github188/bmeter/Docs/无标题.png

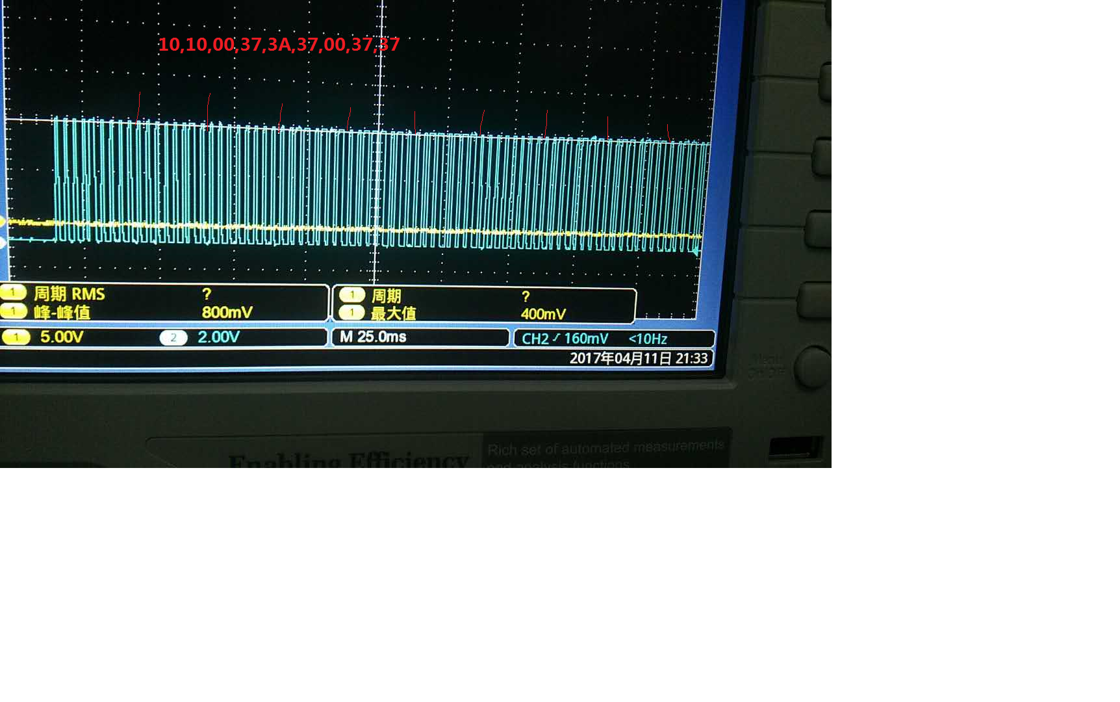
Docs/无标题.png
