github188/bmeter/Docs/JINPENG12080/微信图片_20171207090548.jpg

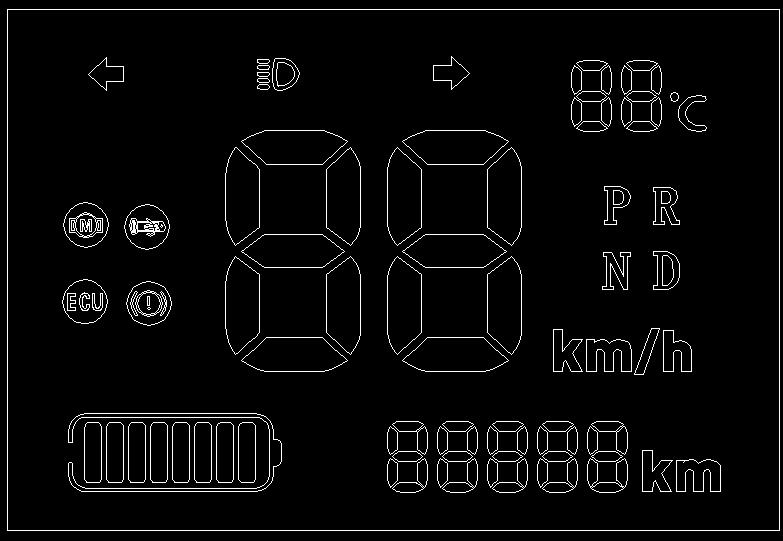
Docs/JINPENG12080/微信图片_20171207090548.jpg
