github188/bmeter/Docs/极客13050 仪表程序需求/Catch.jpg

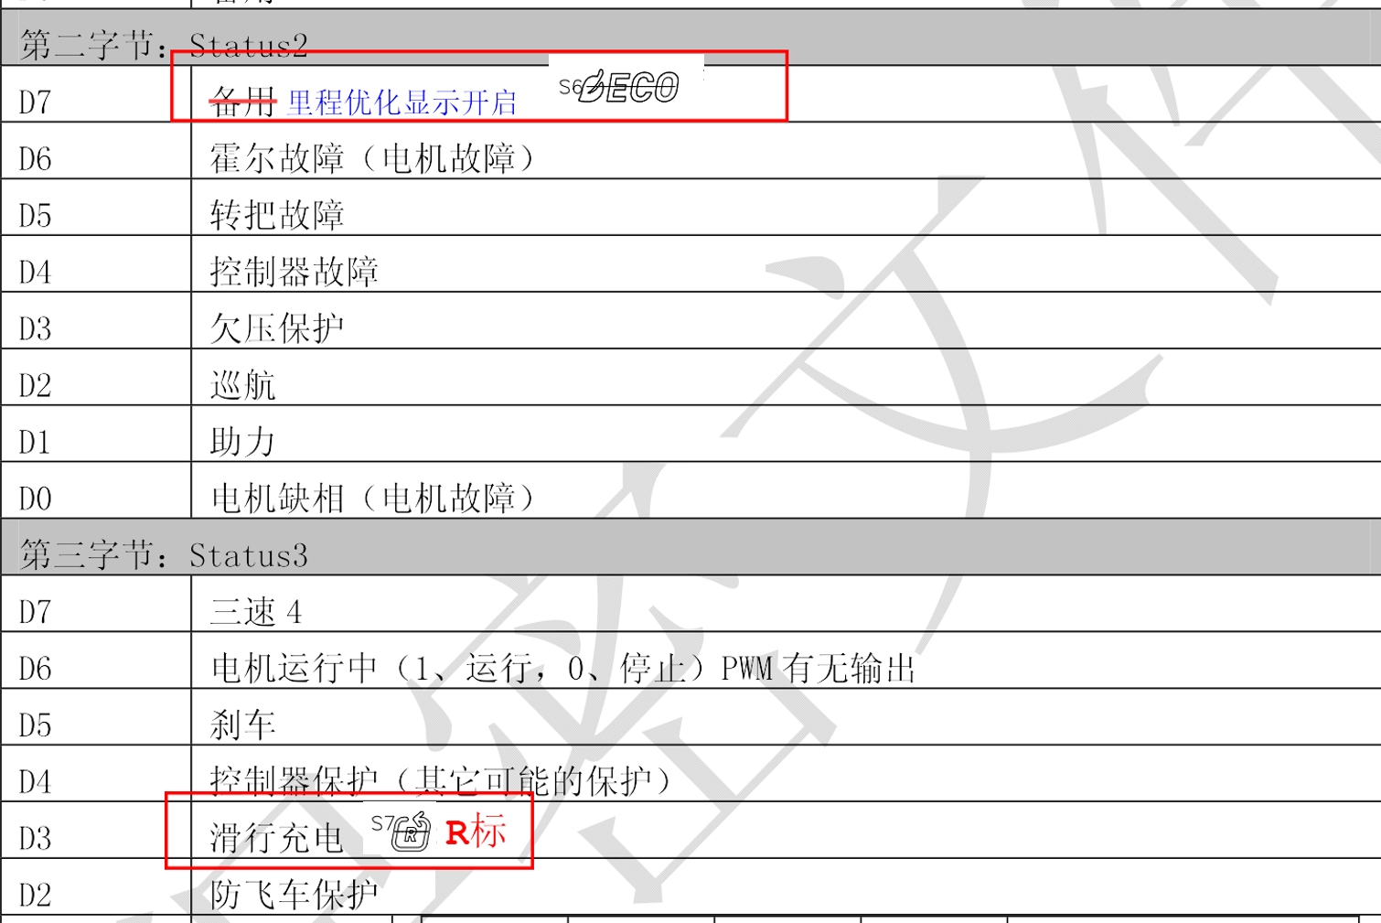
Docs/极客13050 仪表程序需求/Catch.jpg
