github188/bmeter/Docs/仪表软件设置要求/金彭4860 6072软件要求.pdf

48V系统 | 60V系统

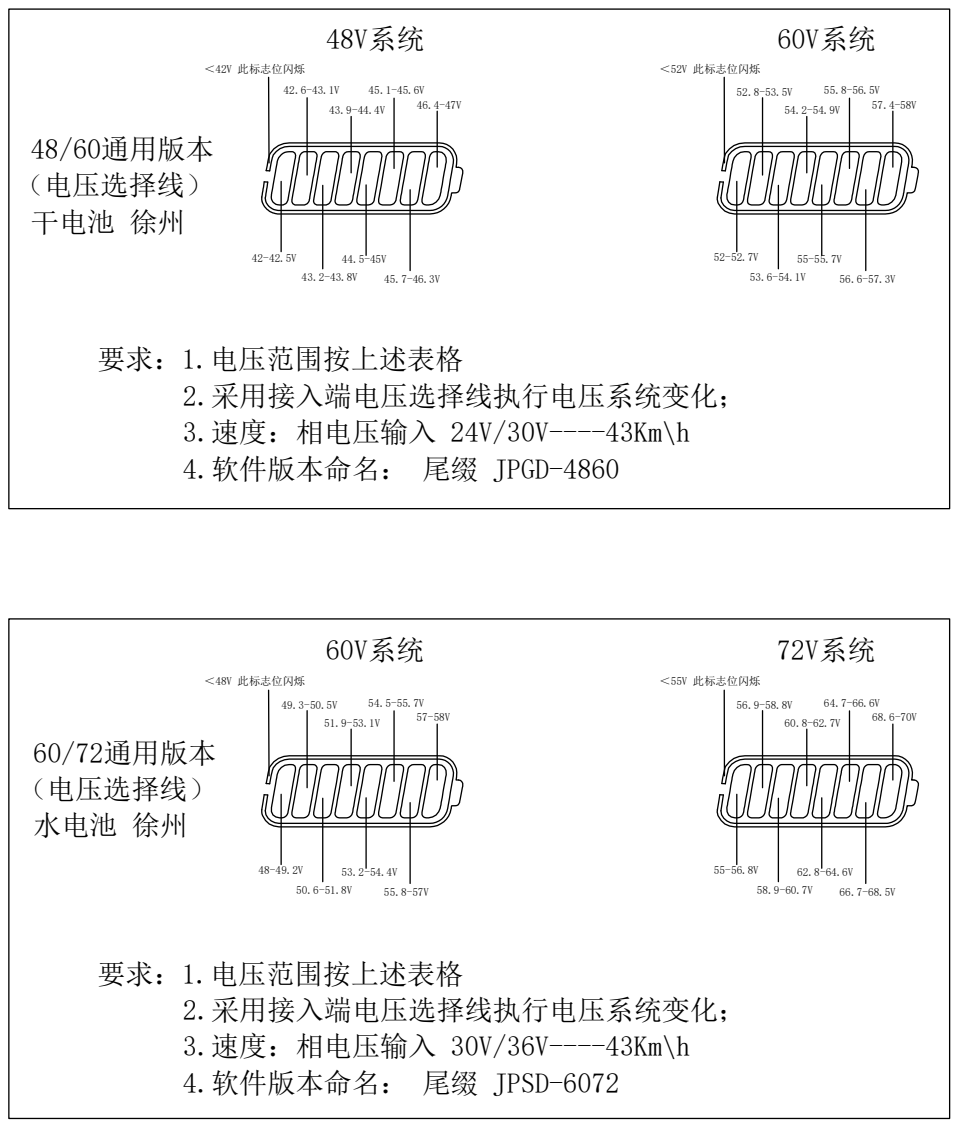
[picture p15: page 1]
42.6-43.1V ＜42V 此标志位闪烁; ＜52V 此标志位闪烁; ＜48V 此标志位闪烁; ＜55V 此标志位闪烁; 48/60通用版本 （电压选择线） 干电池 徐州; 60/72通用版本 （电压选择线） 水电池 徐州; 60V系统; 72V系统; 要求：1.电压范围按上述表格

2.采用接入端电压选择线执行电压系统变化；
3.速度：相电压输入 24V/30V----43Km\h
4.软件版本命名： 尾缀 JPGD-4860

3.速度：相电压输入 30V/36V----43Km\h
4.软件版本命名： 尾缀 JPSD-6072
