github188/bmeter/Docs/Meter011/9040.pdf

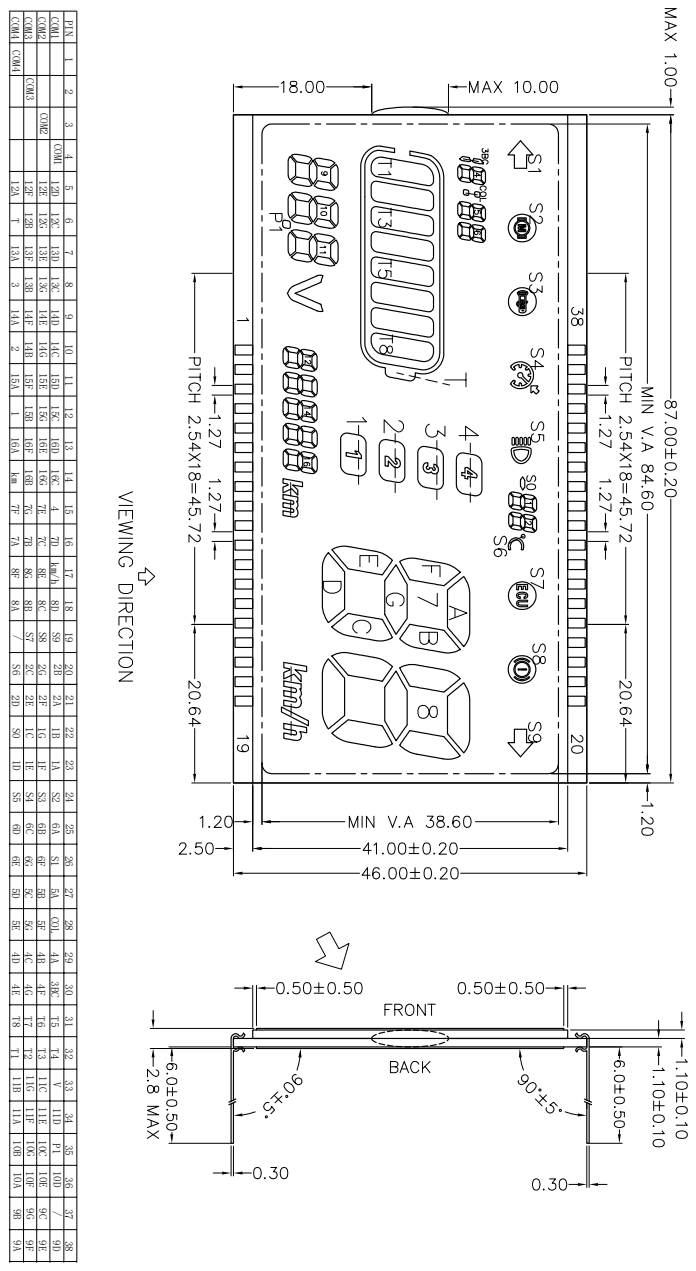
[picture p16: page 1]
PIN 1 2 3 4 5 6 7 8 9 10 11 12 13 14 15 16 17 18 19 20 21 22 23 24 25; COM1 COM1; COM2 COM2; 2E 1C 1E S4 6C COM3 COM3; COM4 COM4; S1 5A COL 4A 3BC
