github188/bmeter/Docs/Meter011/TimeMeter011.pdf

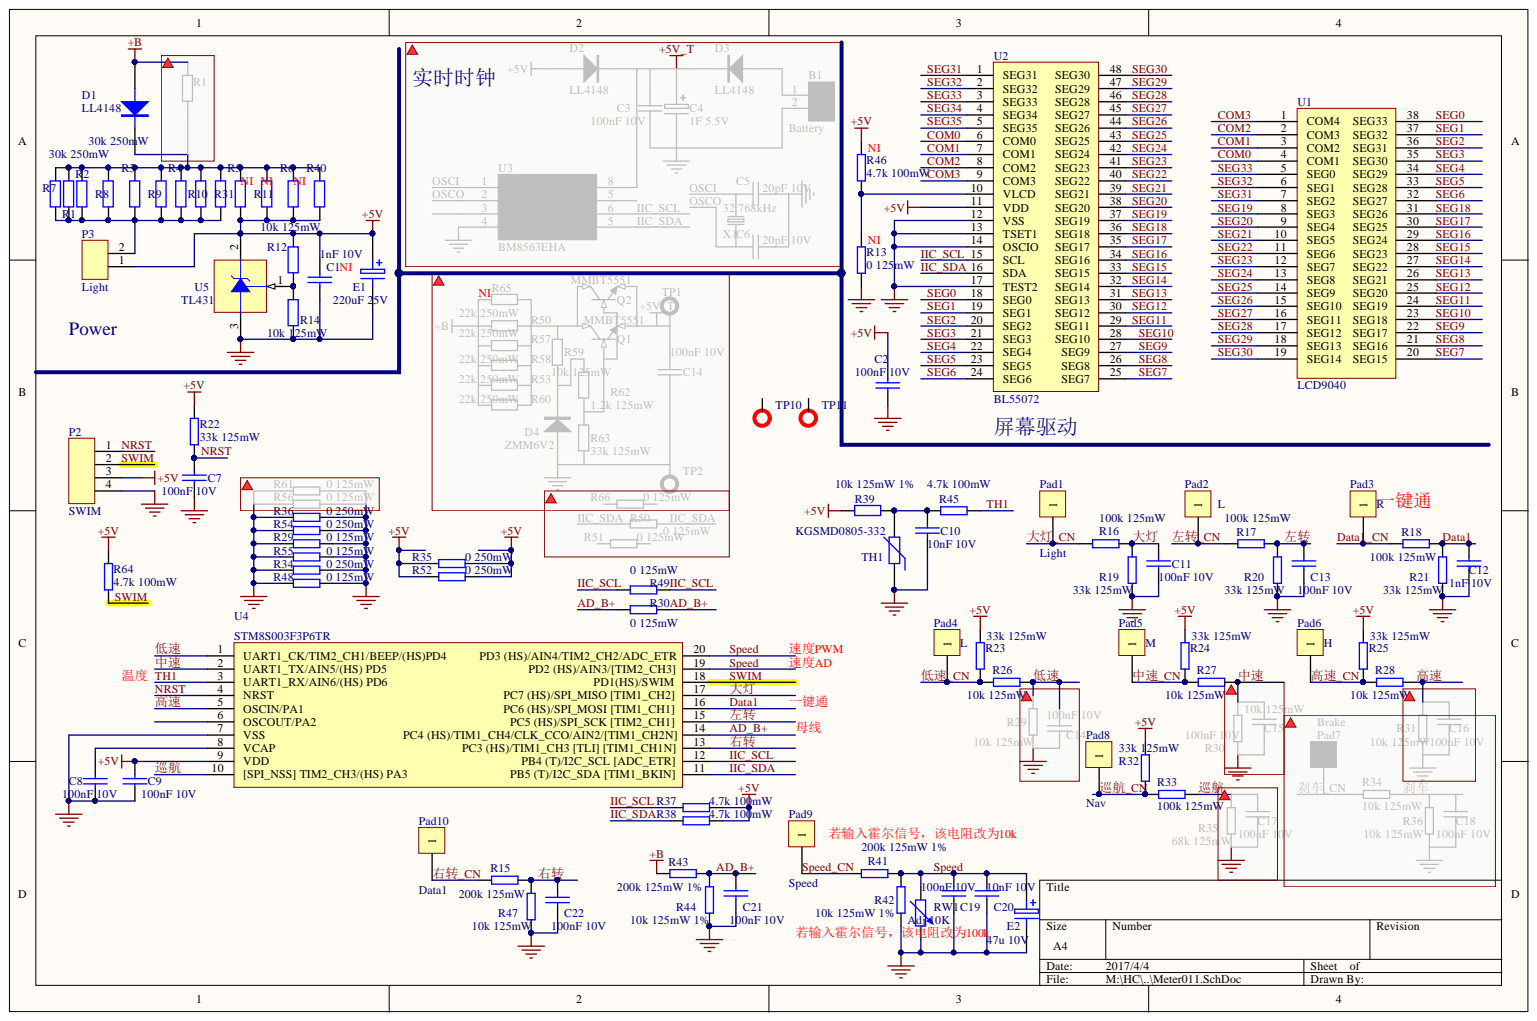
[picture p17: page 1]

SCL 15

1 U5 | MMBT5551 | TEST2 17 | SEG8 13

Brake

C8 | VCAP 8

VDD 9

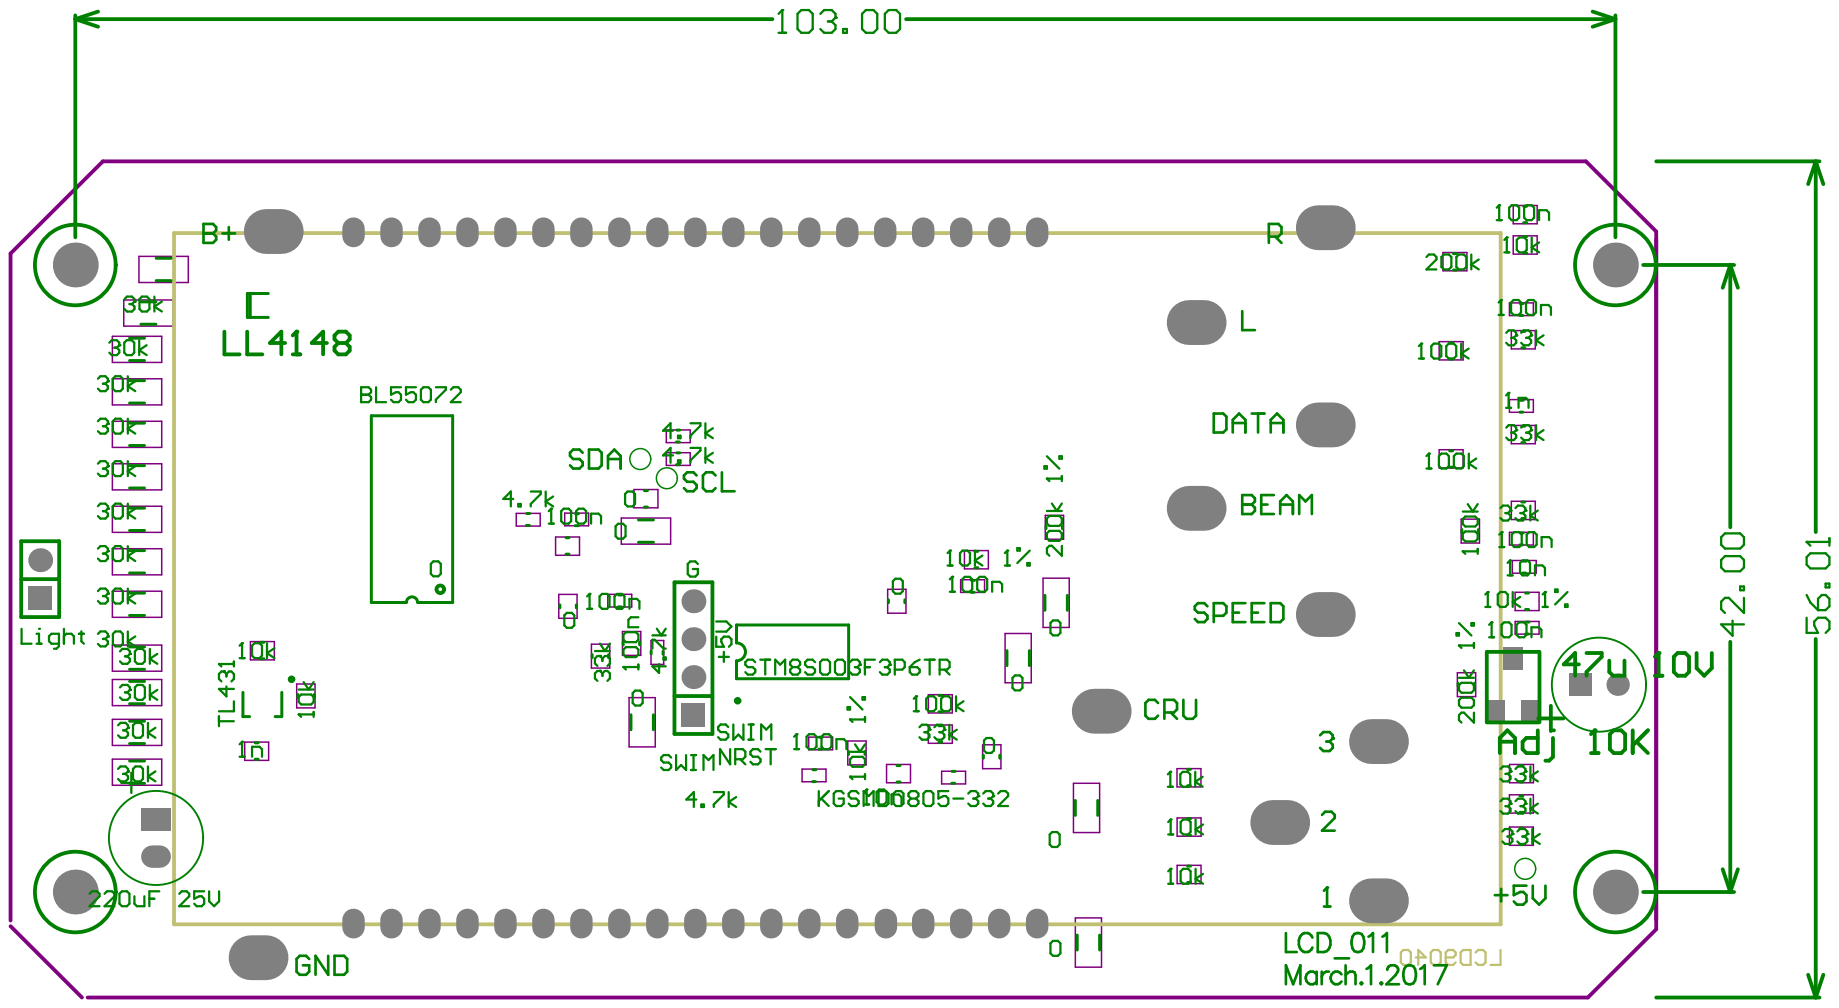
[picture p18: page 2]
