github188/bmeter/Docs/Meter013/Meter013.pdf

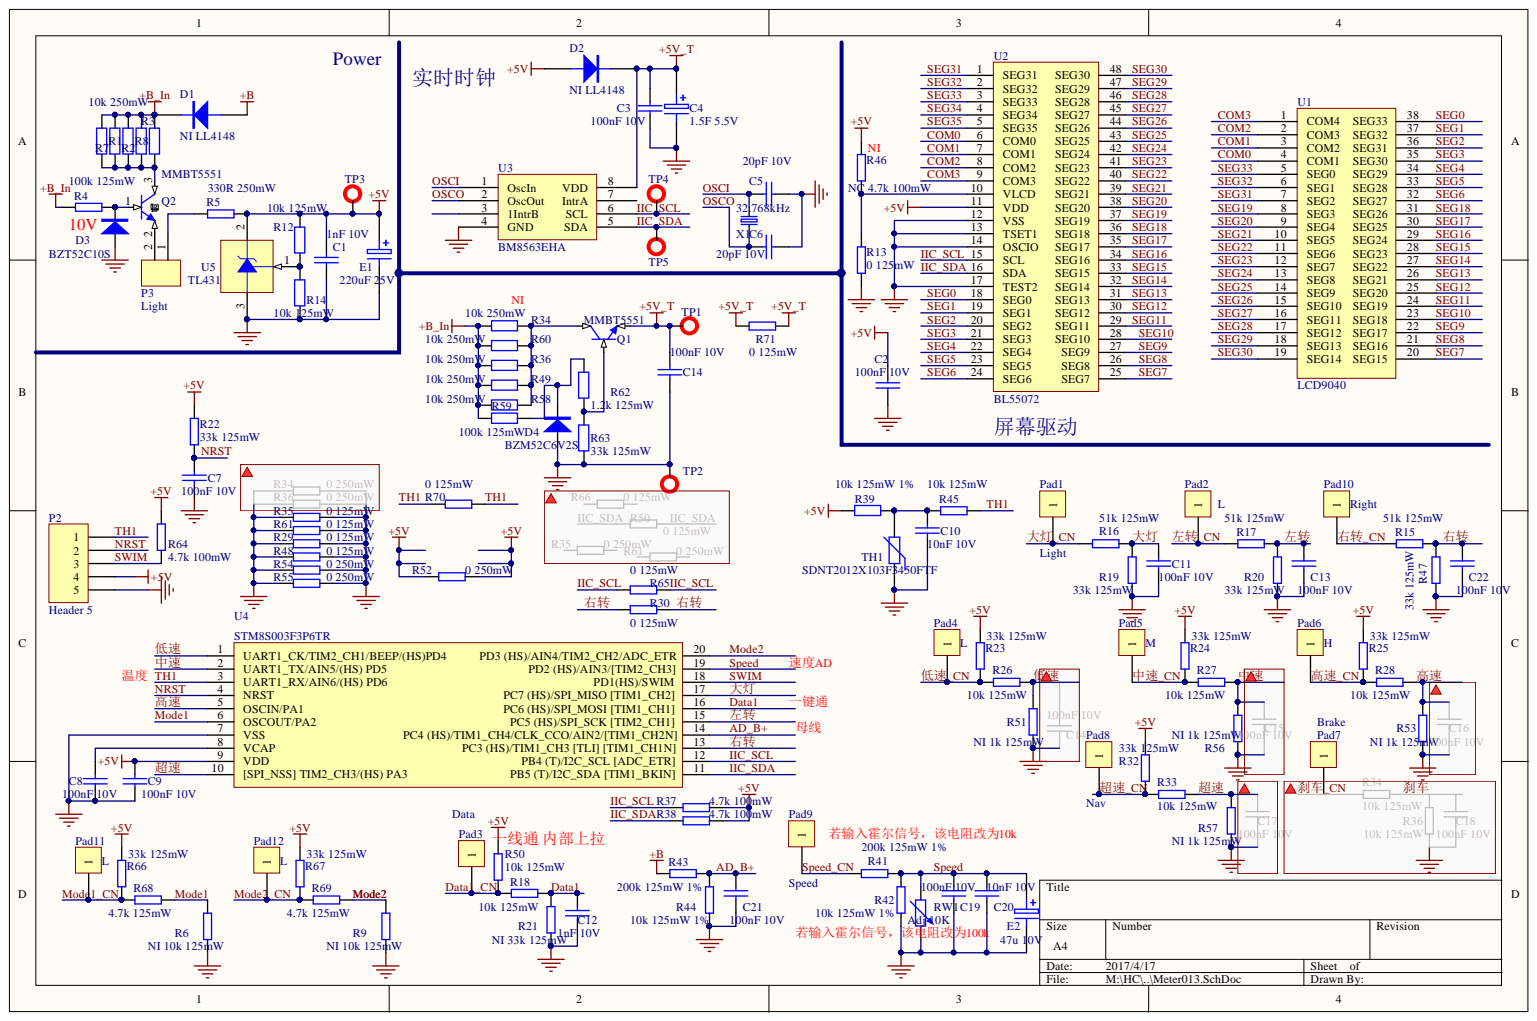
[picture p19: page 1]

TSET1 13

SCL 15

220uF 25V | NI +5V_T +5V_T +5V_T | TEST2 17 | SEG8 13

C8 | VCAP 8

VDD 9
