github188/bmeter/Docs/Meter022/5535.pdf

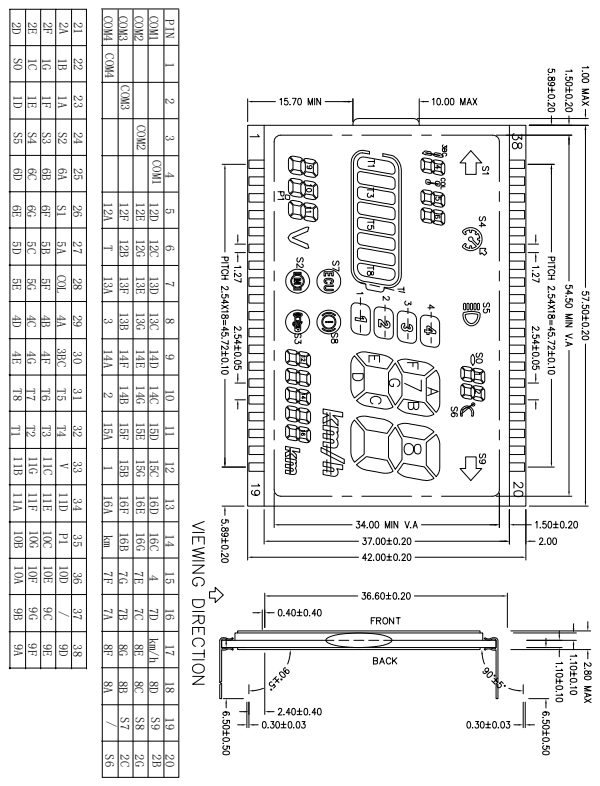
[picture p20: page 1]
PIN 1 2 3 4 5 6 7 8 9 10 11 12 13 14 15 16 17 18 19 20; COM1 COM1; COM2 COM2; COM3 COM3; COM4 COM4; S1 5A COL 4A 3BC
