github188/bmeter/Docs/Meter041/Meter041.pdf

SEG6 24 | SEG7 | 25 SEG8 | 26 SEG9 | 27 SEG10 | 28 SEG11 | 29 SEG12 | 30 SEG13 | 31 SEG14 | 32 SEG15 | 33 SEG16 | 34 SEG17 | 35 SEG18 | 36 SEG19 | 37 SEG20 | 38 SEG21 | 39 SEG22 | 40 SEG23 | 41 SEG24 | 42 SEG25 | 43 SEG26 | 44 SEG27 | 45 SEG28 | 46 SEG29 | 47 SEG30 | 48

## Power

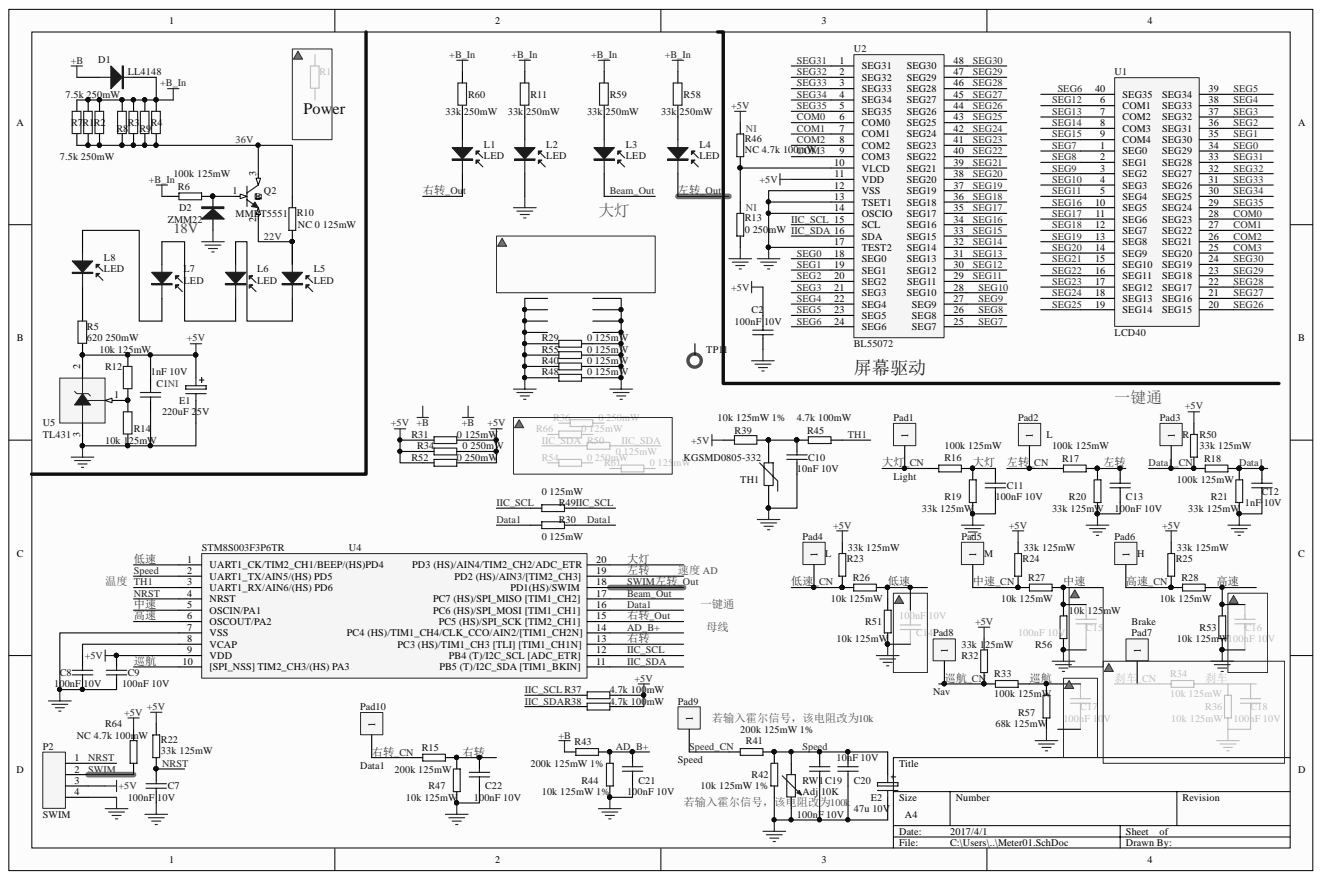
[picture p21: page 1]
