github188/bmeter/Docs/JINPENG12080/MR/MR9737V2.0.pdf

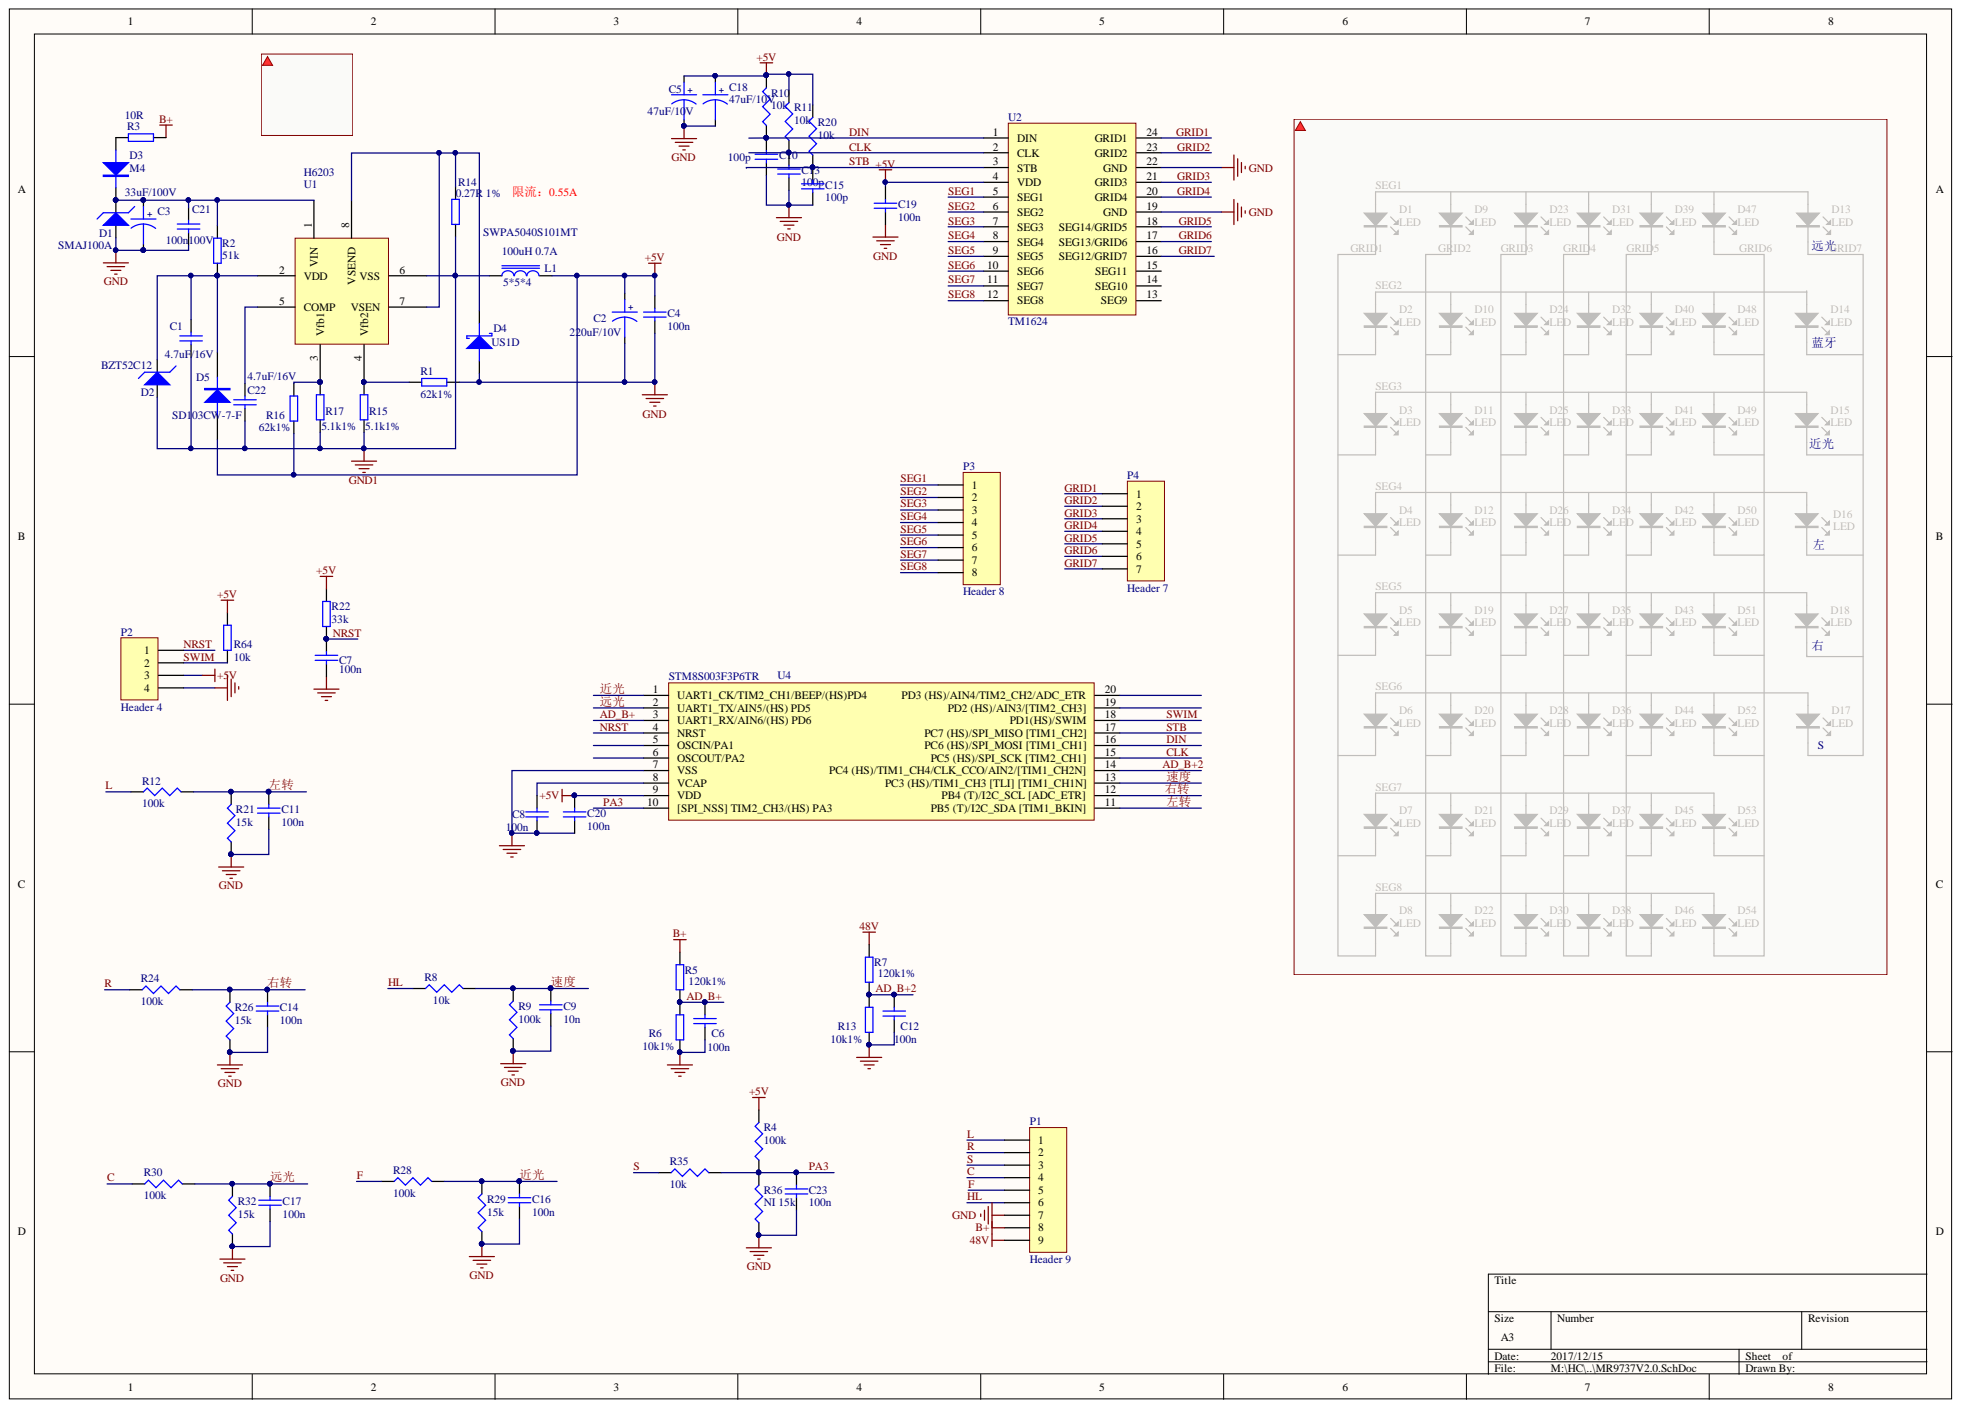
[picture p22: page 1]

4.7uF/16V | | COMP 5 | US1D

SEG3 | D48 LED

SEG4 | D49 LED

C8 | VCAP 8

VDD 9
