github188/bmeter/Docs/JINPENG12080/JP/驱动板/JP-QDB.pdf

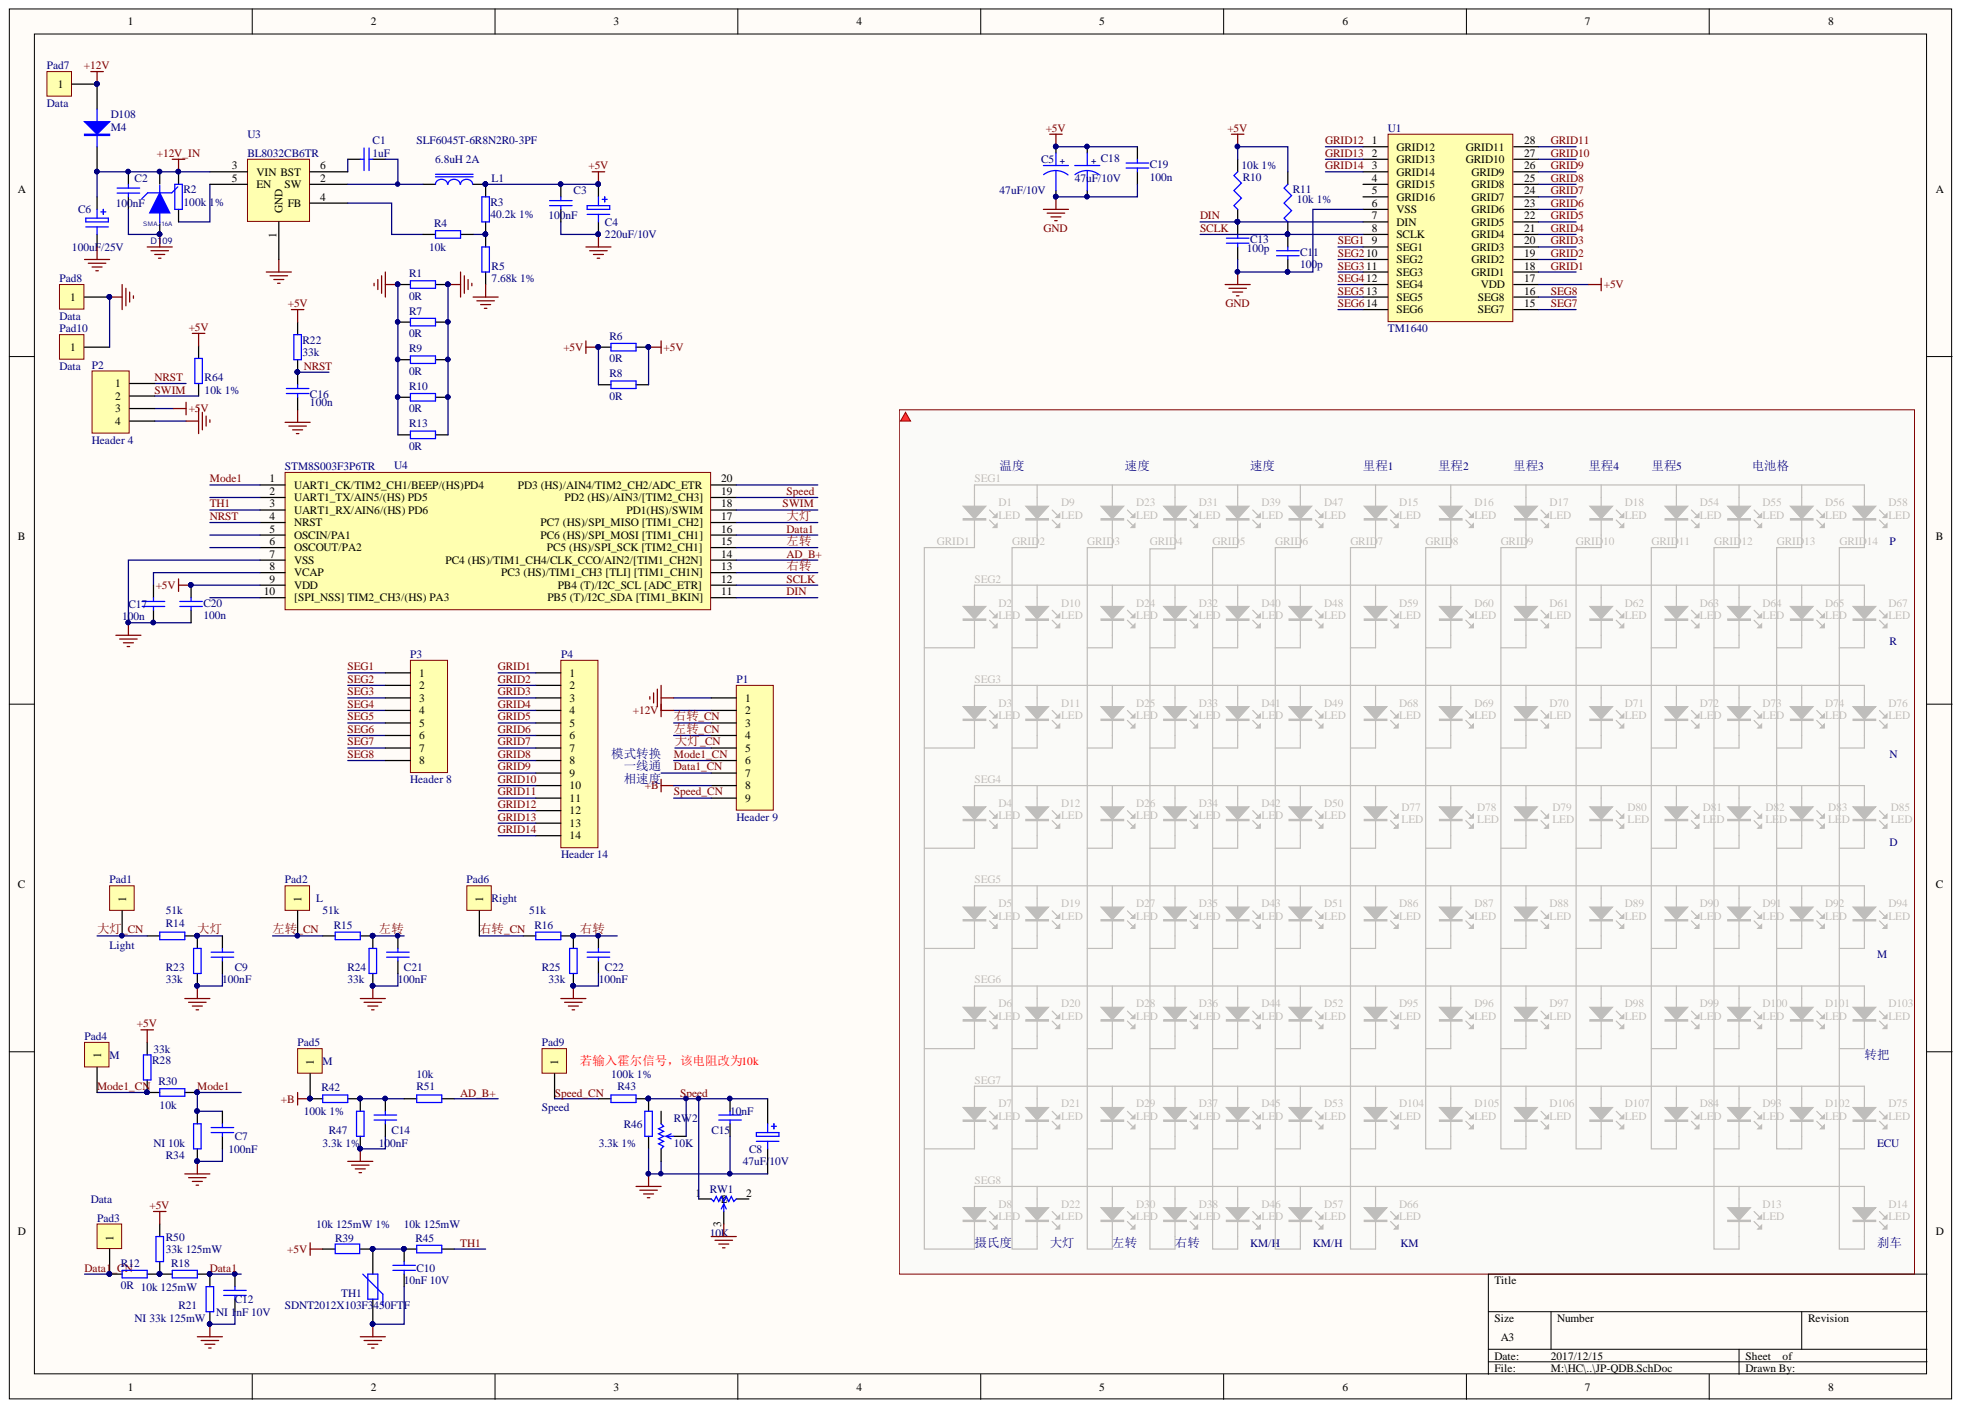
[picture p23: page 1]

C17 | VCAP 8

D2 LED SEG3 | D10 LED | D24 LED | D32 LED | D40 LED | D48 LED | D59 LED | D60 LED | D61 LED | D62 LED | D63 LED | D64

D5 LED SEG6 | D19 LED | D27 LED | D35 LED | D43 LED | D51 LED | D86 LED | D87 LED | D88 LED | D89 LED | D90 LED | D91 LED

D6 LED SEG7 | D20 LED | D28 LED | D36 LED | D44 LED | D52 LED | D95 LED | D96 LED | D97 LED | D98 LED | D99 LED | D100 LED | D101
