github188/bmeter/Docs/8807.pdf

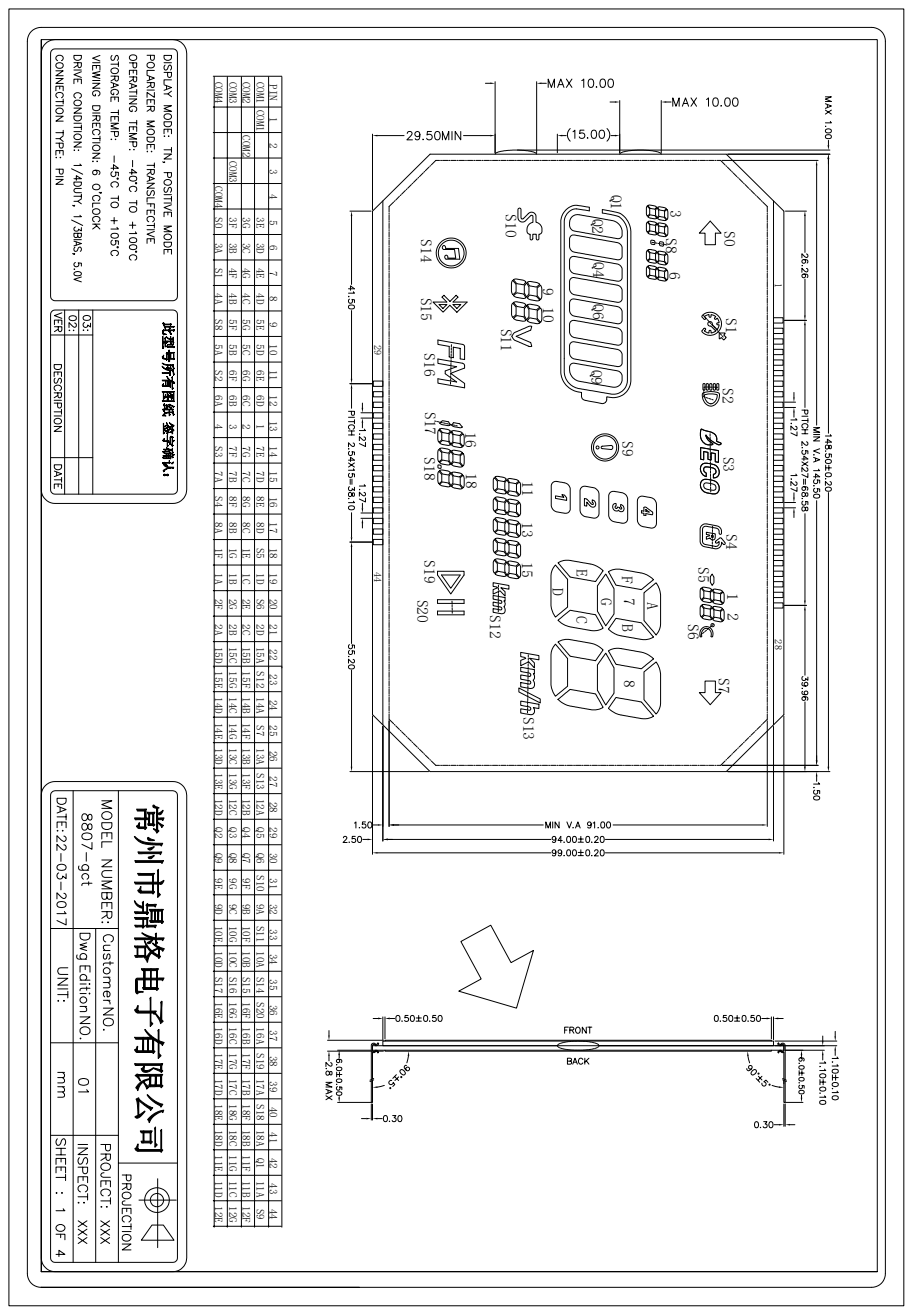
[picture p24: page 1]
