github188/bmeter/Docs/YB说明.pdf

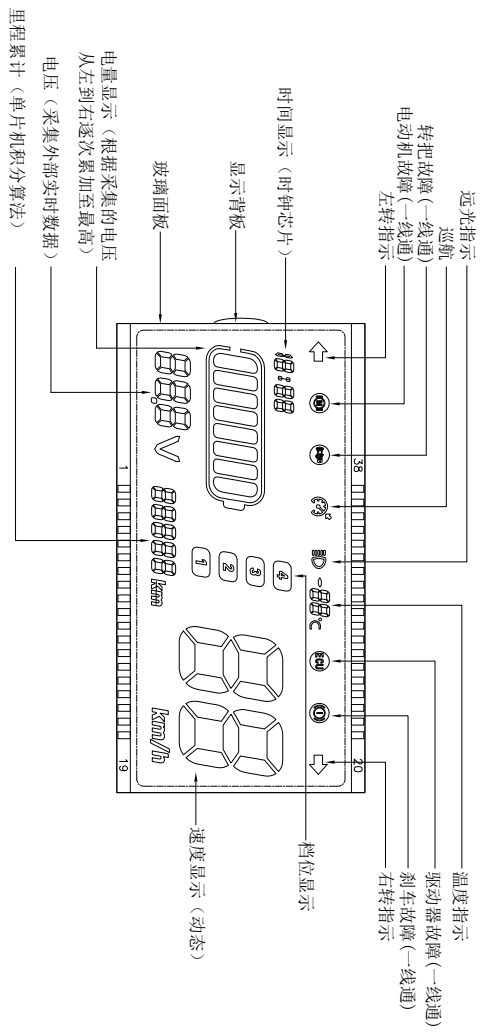
[picture p25: page 1]
左转指示; 电动机故障(一线通); 远光指示; 右转指示; 刹车故障(一线通); 驱动器故障(一线通); 速度显示（动态）; 里程累计（单片机积分算法）; 电压（采集外部实时数据）; 从左到右逐次累加至最高）; 电量显示（根据采集的电压; 档位显示; 时间显示（时钟芯片）; 玻璃面板; 显示背板; 温度指示; 转把故障(一线通)
