github188/bmeter/Docs/JINPENG12080/金彭LED原理图.pdf

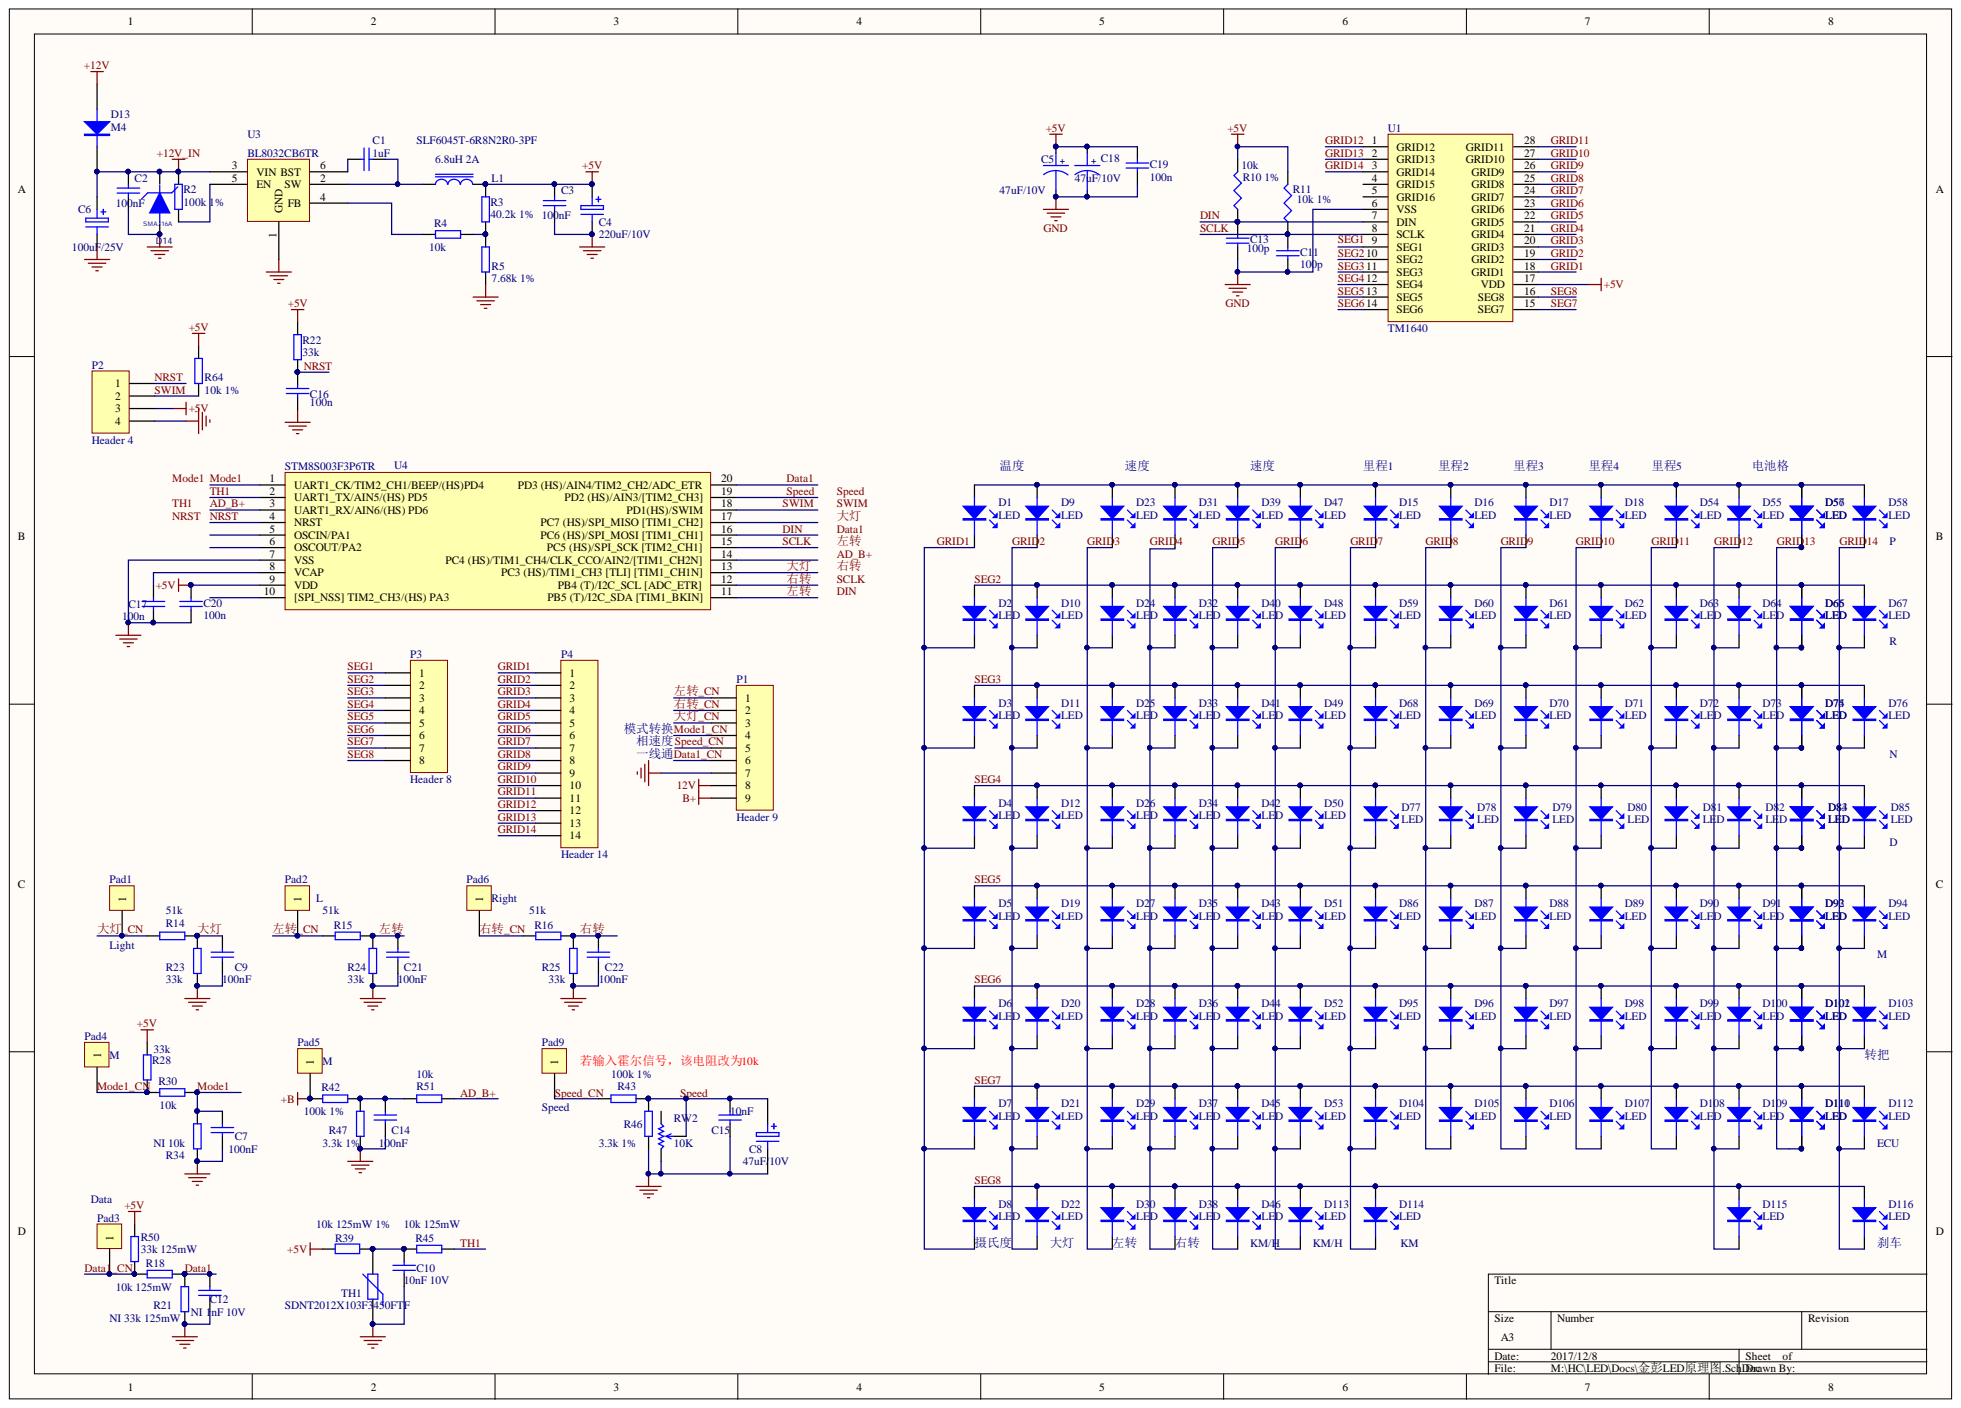
[picture p26: page 1]

C17 | VCAP 8

SEG3

SEG6

SEG7 | D100 | D101 D102
