github188/bmeter/Docs/仪表软件设置要求/48 60切换.pdf

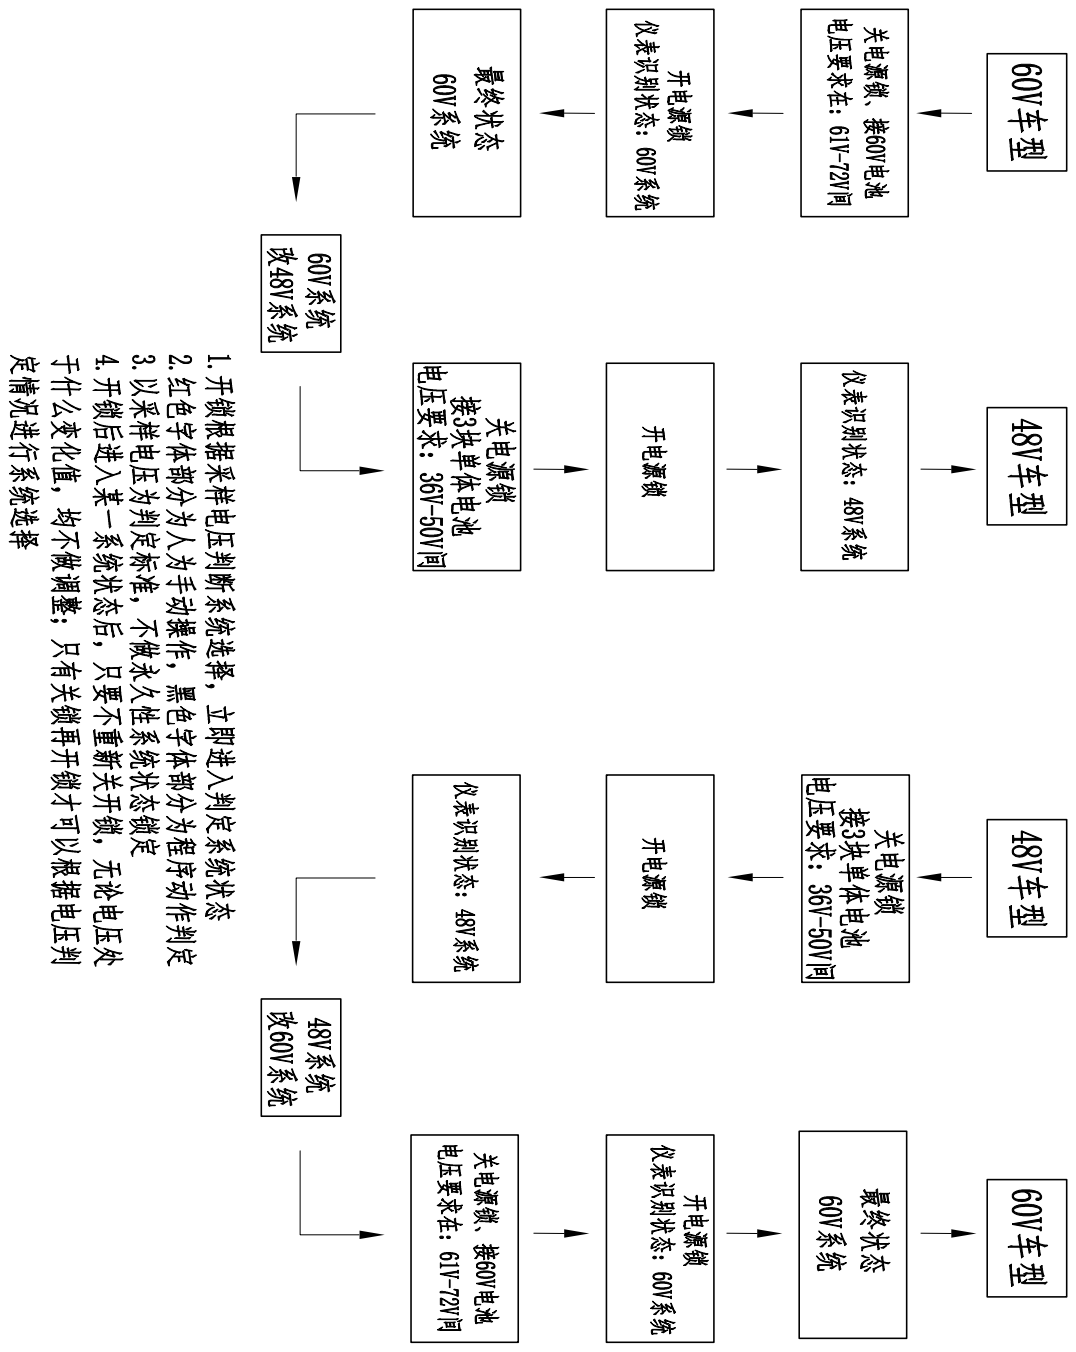
[picture p27: page 1]
