github188/bmeter/Docs/仪表软件设置要求/本铃自动判断仪表说明60-72.pdf

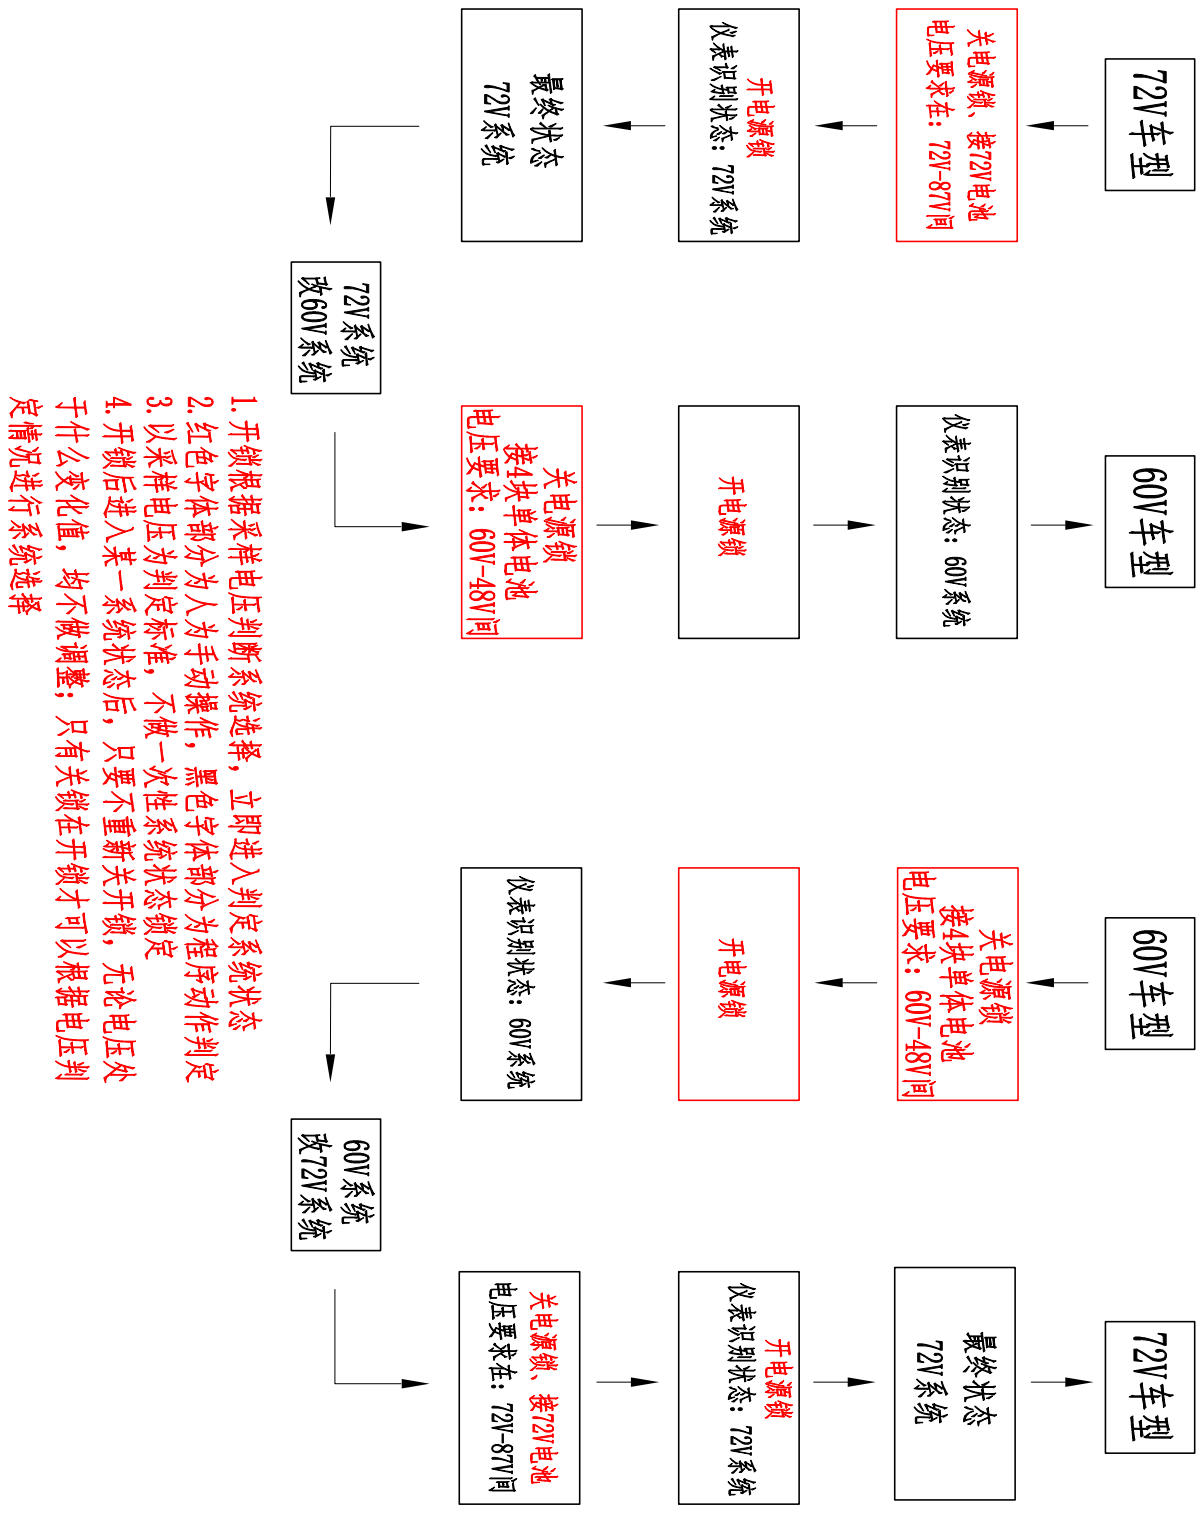
[picture p28: page 1]
