github188/bmeter/Docs/Meter022/TimeMeter022.pdf

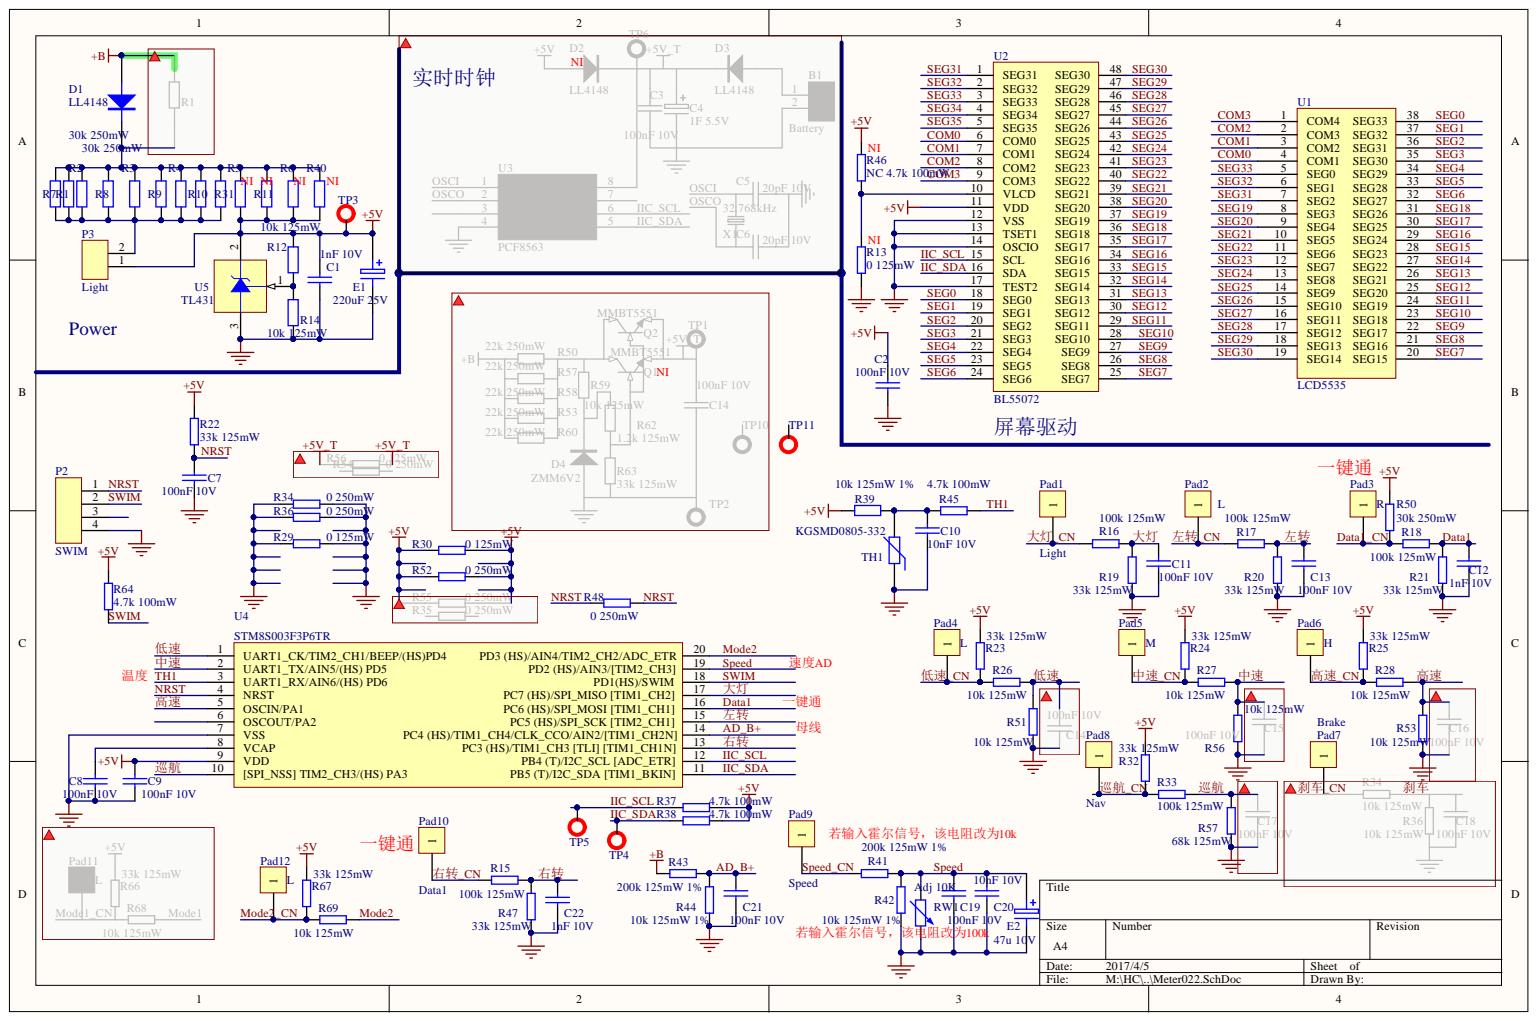
[picture p29: page 1]

SCL 15

1 U5 | TEST2 17 | SEG8 13

C8 | VCAP 8

VDD 9

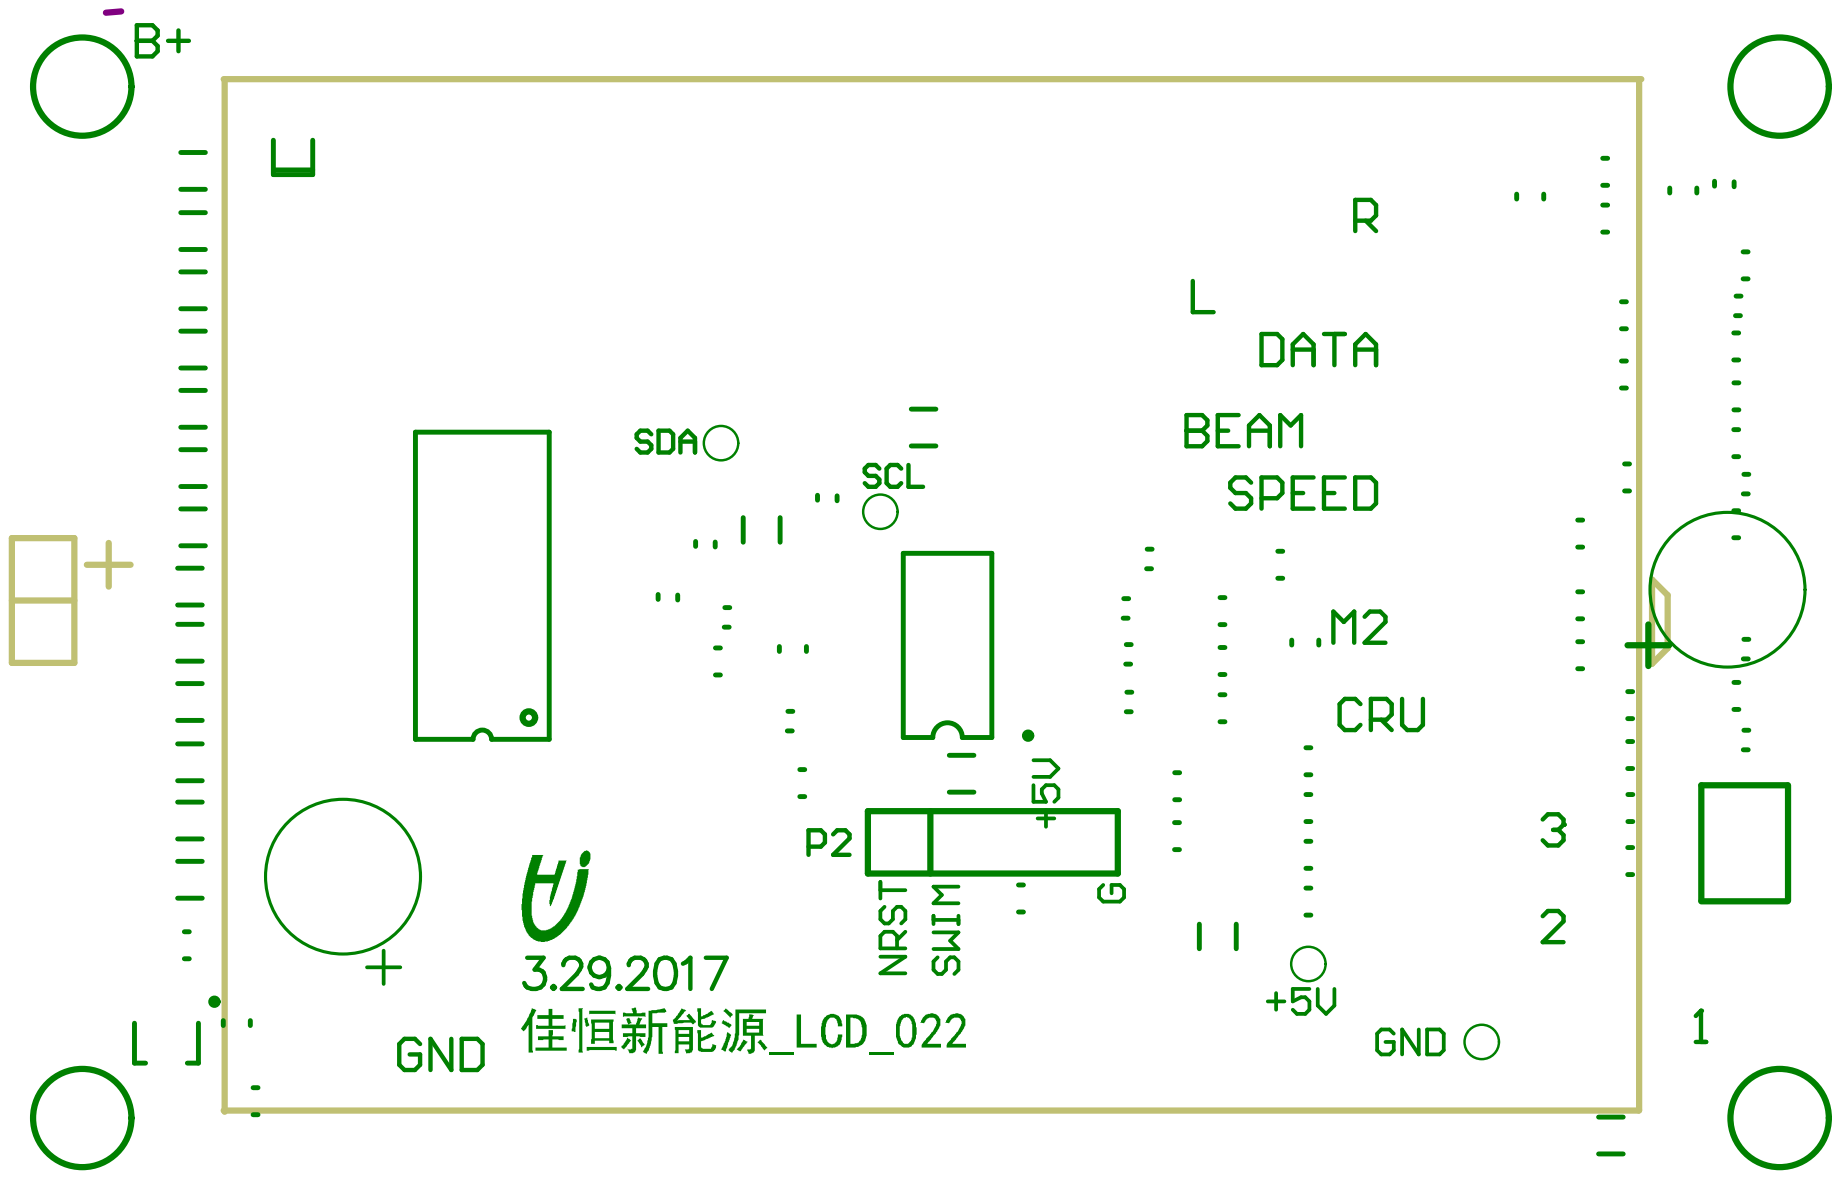
[picture p30: page 2]
