github188/bmeter/Docs/Meter023/Meter023.pdf

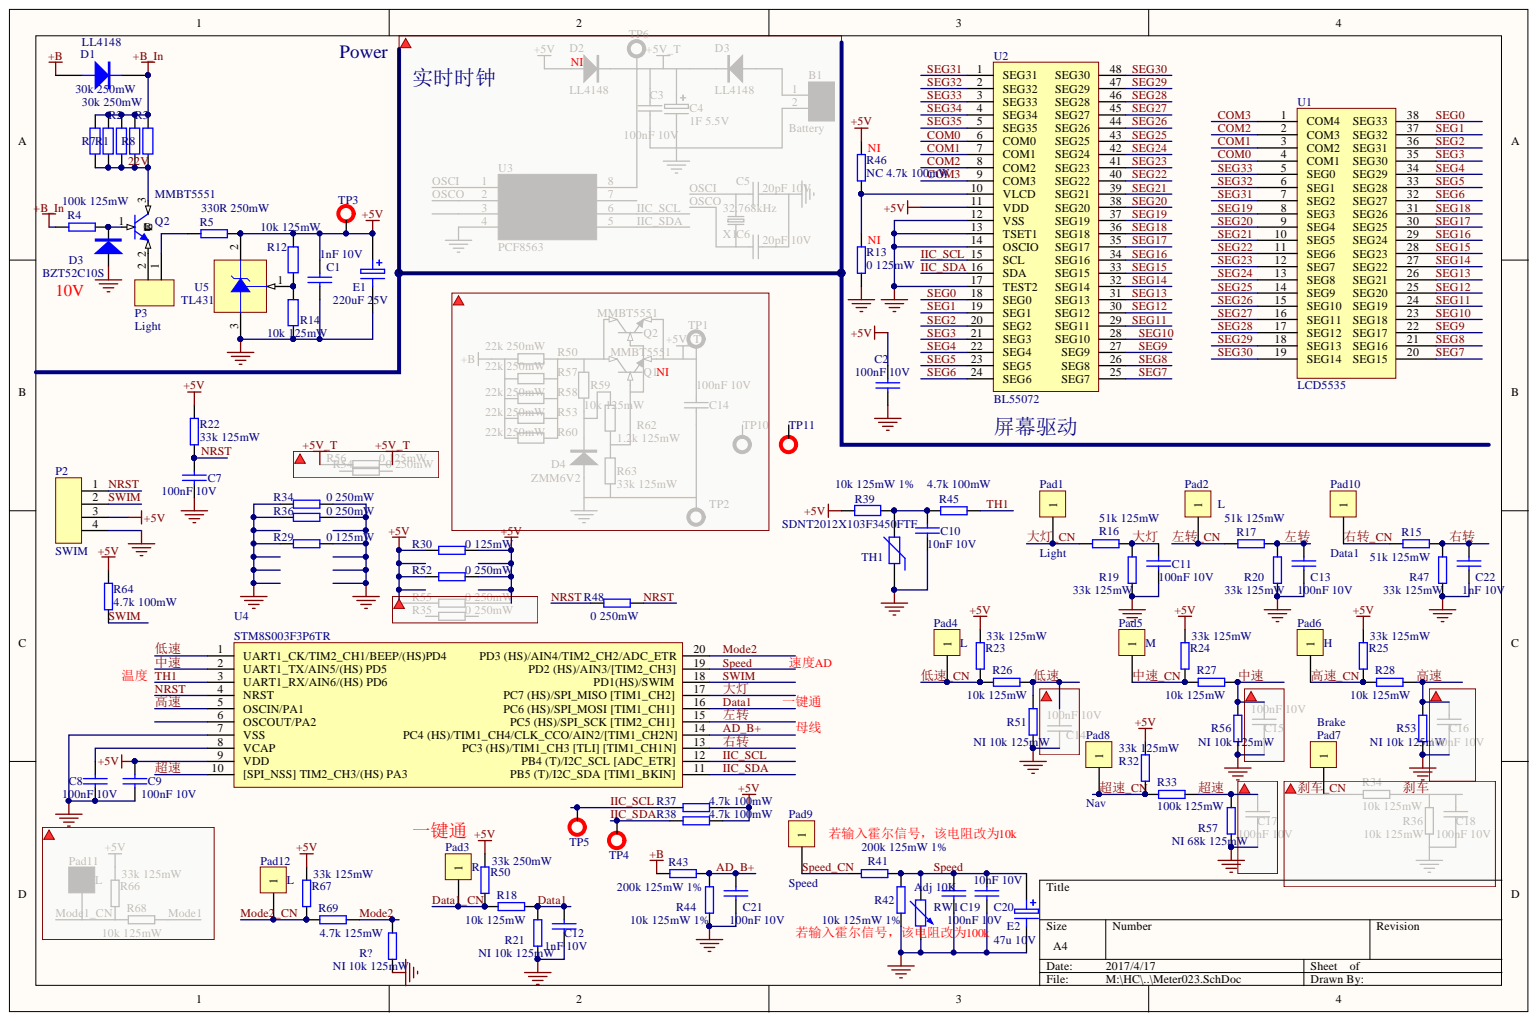
[picture p31: page 1]

SCL 15

1 U5 | TEST2 17 | SEG8 13

C8 | VCAP 8

VDD 9
