github188/bmeter/Docs/Meter041/8794-gct.pdf

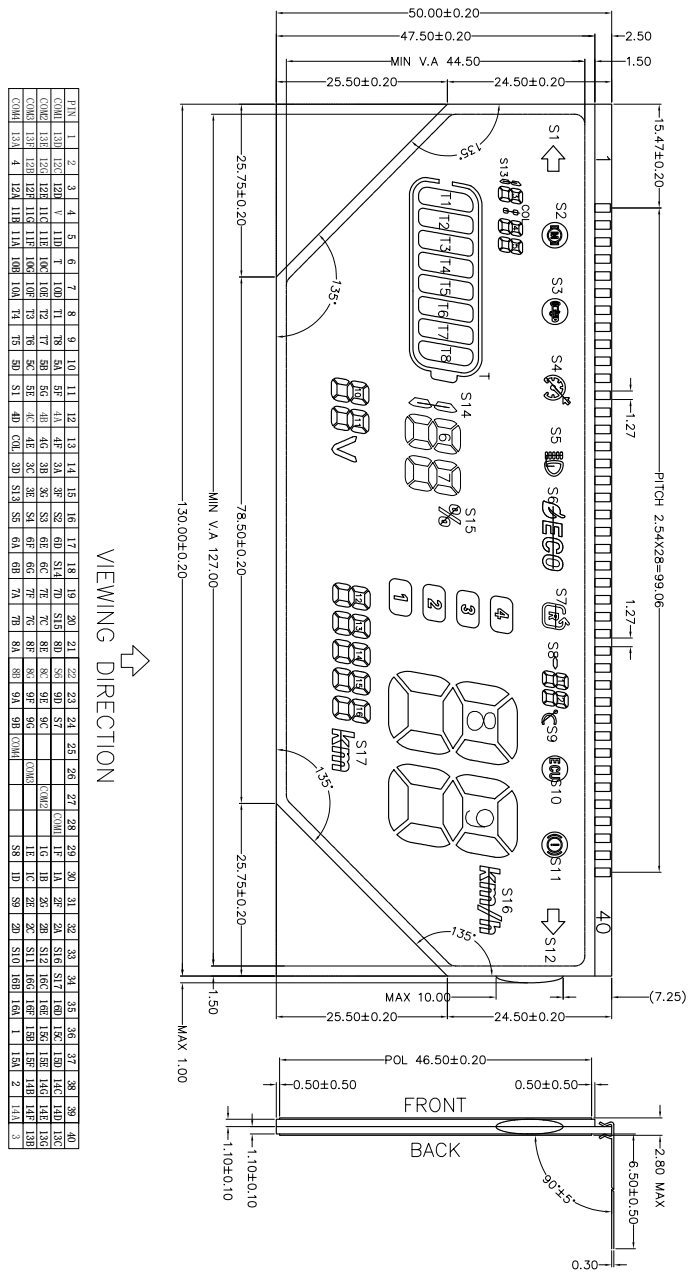
[picture p32: page 1]
COM1 12D 11D T 10D T1 T8 5A 5F 4F 3A 3F S2 6D S14 7D S15 8D; 4 12A 11B 11A 10B 10A T4 T5 5D S1 4D COL 3D S13 S5 6A 6B 7A 7B 8A; COM1 1F 1A 2F 2A S16 S17 16D 15C 15D 14C 14D 13C; 9E 9C COM2 1G 1B 2G 2B S12 16C 16E 15G 15E 14G 14E 13G; COM3 1E 1C 2E 2C S11 16G 16F 15B 15F 14B 14F 13B; PIN 1 2 3 4 5 6 7 8 9 10 11 12 13 14 15 16 17 18 19 20 21; COM4 13A 4 12A 11B 11A 10B 10A T4 T5 5D S1 4D COL 3D S13 S5 6A 6B 7A 7B 8A; COM3 13F 12B 12F 11G 11F 10G 10F T3 T6 5C 5E 4C 4E 3C 3E S4 6F 6G 7F 7G 8F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
