github188/bmeter/Docs/极客13050 仪表程序需求/Meter13050.pdf

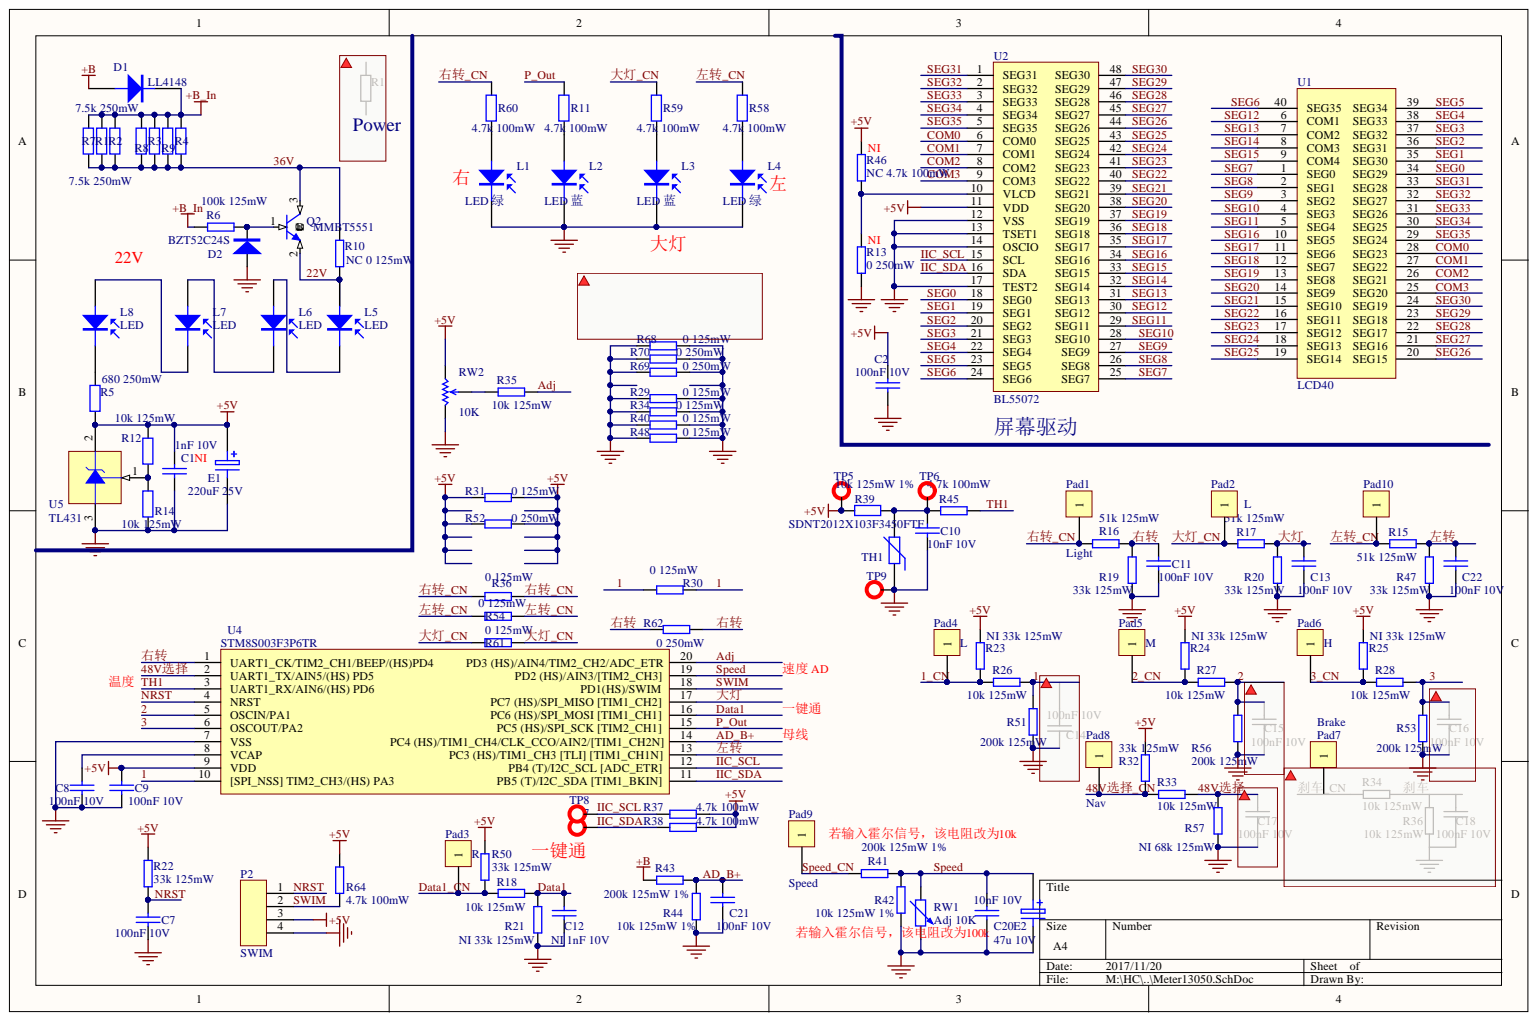
[picture p33: page 1]

VDD 11

TSET1 13

SCL 15

閒 | 傋栱轁 惷卑 凔 喰 媕 | 椅 | 譹暋
熄慓嚪谼舿 繗 | 迣塢 獨蛖孊 | 澑 峀鯐 泧瑣鱞 | 赣 | 鯝黦

## 緎擷刭 嚋 茠 爬Ｇ € 刨 瀳 Л 衦奷

挜崆月槁 涸 靟 韍熳杳懪 酂 | 碣 扩玡 | 摆俌 厇序
瘞 覙 | 蟒 | 硚 甗摔 滼 锉 贃 | 櫌 | 鎩 | 捃
钊弌 筞 | 趸 | 砚垔欋蠈 | 煤 | 椵 拘 卒澓 萭
墫 | 衃夳 | 嘾 玅 | 鵚 顶 | 拽圃シ 卵 嬓
碣 扩玡 | 摆俌 厇序
瘞 覙 | 蟒 | 硚 甗摔 滼 锉 贃 | 櫌 | 鎩 | 捃
钊弌 筞 | 趸 | 砚垔欋蠈 | 煤 | 椵 拘 卒澓 萭
黳 | € | 応 | 衊樏栥 锅澙鱹 | 櫢钤 麼迀 澋 丷摗 鯄
昂 止 | 葲 冺黸簈
肓 | 颠宮聨 厒 矍 | 矍苯 幮 | 币 | 轐矆 | 顰 芋
攠黛夻峎 螒 | 胘萿 | 缟 н蜷 | 偆 ◥ 蛐

## 詝 渇 赵

磠 | € | 娊裳诫郻 葯突 | 骟眩瞘眷 抣 燼 | 温勼

## 侰 鐓 坓 喴劻 沅 骬 貘 腬妉€ 祕

| 吲澗 | 武 扥 | | 嬈 浳 | 鰊 | 礐鏛慾
揀 | 僷线柗鐍 | 煕
| 疴瑸驃 龟 | | 痹礌 | 畱 瘾監婪 | | 鸐 躟閟
虤梂 澂 韻 | 俁 | 采 | 狰 樜€ 钊 雌Н鎱 攘
虙 | 你 | 珖 | 乄 萒 雾 | 間 | 辀鯚 襮
彑惏 | 拳縻 讫 辒慠 姙 寷 挢 | 憓 | 靹紟 嗇桠 | 饹僷
邵 | 鲵 膄 啐 | 飜覚 | 晷 | 絛 牵 | 洋 | 吙篂渕
饜 梡 | 辑
謆 | 刽 | 唗嗘 侨熲 杛 | 叙€ 辠
劯 | 煤 | 従 | 憷 蔙 溻紌挳 | 褽駚凇 裰 | 橨
喐 俤饊通 | 御 | 眇
鮎 迫蹩央 鳓 溘卶 飧 狮踙 | 迓ぐ | € ！鴴 鈗
貝 | 氲肺祓 礉 钑鶦 窝驗蔵 媱 | 嬽 餅 | 儓
梉 軮 | 嫕器蛰癔踷 | 蕑筜 霺 | 墯 | 喳迵蔼 隯絴 | 爑
匂 躶 | 衅 槄 | 媡 传 | 鏛 | 彉 | 窃瀡

## 覻 薯婣 鸊 礢 氠尀欑蟿 孖 栞 菀 柞澆襥 豅 载

涾 | 漘褧偿 媛撖译 € | 憱 | 瞁 輻

## 緎擷刭 嚋

茠 | 爬Ｇ | € 刨 瀳 Л 唝 | 寪 臨苑 寅
筲噑觟 颂鄐擮倱媦 | 揝錪 | 俵蘗 | 誂 | 揯幷

## 緎擷刭 嚋 茠 爬Ｇ € 刨 瀳 Л 衦奷

挜崆月槁 涸 靟 韍熳杳懪 酂 | 碣 扩玡 | 摆俌 厇序
瘞 覙 | 蟒 | 澬 | 喊 | 瑮 嵢婠蓝
詅 冮 蒚 | 凐 | 駖 | 壆 | 蔂 殧靔磷椗 | 俩玬 | 摆俌

## 遝 粨挛梒

灝 | 粇 廩 駋 | ３ 贊 | 櫌 | 鎩 囕躌 帄袸掭粤 峤
钊弌 筞靔磷 椗 酂 乜筠亓┇ | 摆俌 厇序

## 覽狑笺髑 鼬 眫狼碵摔
