github188/bmeter/(list of files, drawings)

Other design files:
Docs/JINPENG12080/JP/LED/JP-LED.SchDoc
Docs/JINPENG12080/JP/驱动板/JP-QDB.SchDoc
Docs/JINPENG12080/MR/MR9737V2.0.SchDoc
Docs/JINPENG12080/金彭LED原理图.SchDoc
Docs/Meter013/Meter013.SchDoc
Docs/Meter013/MP3.SchDoc
Docs/Meter020/Meter020.SchDoc
Docs/Meter023/Meter023.SchDoc
Docs/仪表自测5.3.SchDoc
Docs/极客13050 仪表程序需求/Meter13050.SchDoc
