github188/bmeter/(commit log)

2017-07-18 modfiy Calibration and InitConfig
2017-07-18 * V2.07 * 增加一线通支持类型，支持型号以外的，直接从Status9中恢复PlusCode;
2017-07-18 * V2.07 * 修正对一线通吉详方案的支持，数据高电平采空比放宽到15-42
    [bike.h, yxt.c]
2017-07-22 * V2.08 * 增加开机显示累计里程5秒，如果2秒后有速度则跳到显示单次里程
2017-08-17 * V2.08 - 20170817 * 修改刹车图标显示方式，当YXT DATA2 BIT5 为1时显示刹车灯 * 改正DENGGUAN_XUNYING_T、JINPENG_6072的速度标定 * 优化程序空间
2017-08-21 * V2.09 - 20170821 * 增加了开机3秒内开关8次大灯对总里程进行复位的方法；
2017-08-22 * V2.09 - 20170821 * 增加了开机3秒内开关8次大灯对总里程进行复位的方法； * 左右转信号由中断改为程序扫描方式； * 增加批量编译功能；
2017-08-24 * V2.10 - 20170824 * 修改总里程进行复位的方法：打右转灯，开机后10秒内开关大灯8次； * 左右转信号改回中断方式，适应闪光器； * 增加OUPAINONG四个版本的支持； * 改正OUPAINONG_6072版本的电压识别；
2017-08-30 * V2.10 - 20170830 * 修改左右转灯为独立闪烁 * 修改工程结构
2017-08-30 * V2.11 - 20170830 * 修改左右转灯为独立闪烁 * 修改工程结构
2017-09-08 * V2.11 - 20170908 * 按9040_5535型仪表软件设置要求-0908.doc进行更改： * 1. 60/72V系统，电池图标对应电压值 * 2. 无挡位输入时，相电压对应速度 * 3. 计算累积里程时，设定的最高速度
2017-09-08 * V2.11 - 20170909 * 增加LCD9040_4860版本
2017-09-09 * 修正最高速度限制
2017-09-10 * 更改ＧetVol函数和程序结构使用电源快速开关过程中，仪表显示不变． * 开机全显时间改为２秒．
2017-09-15 * V2.12 - 20170916 * 按9040_5535型仪表软件设置要求-0914.docx进行更改 * 增加MileResetTask,YXT_SpeedCaltTask两个功能．
2017-09-17 * V2.12 - 20170916 * 按9040_5535型仪表软件设置要求-0914.docx进行更改 * 增加MileResetTask,YXT_SpeedCaltTask两个功能． * 增加相电压速度时的调节功能，改下一线通电压时初始化的问题．
    [bike.h, display_6040.c, display_8794GCT.c, main.c, stm8s_it.c]
2017-09-27 * V2.13 - 20170921 * 改正左右转闪光器信号的识别，MileResetTask,YXT_SpeedCaltTask两个功能可以更稳定工作
2017-10-27 * V2.20 - 20171027 * 统一清里程、速度设定的方法；兼容左右灯开关信号和闪光器信号；统一变量命名方式；
2017-11-02 * V2.21 - 20171102 * 增加参数设置单次里程功能，可以通过开关操作进行设置；
2017-11-20 * V2.22 - 20171120 * 增加对9040基本版本2.0PCB的支持、JIKE13050版本的支持 * 增加相关设计文档
    [9040_5535软件版本说明0823.xlsx, 9040_5535软件版本说明V0.1.xlsx, LCD8794-gct.xlsx, MP3.SchDoc, Meter013.SchDoc, Meter020.SchDoc, Meter023.SchDoc, Meter13050.SchDoc]
2017-11-25 * V2.24 - 20171125 * 改正速度修正的问题；
    [bike.h]
2017-11-27 * V2.25 - 20171127 * 增加软件版本配置信息，当程序检测到版本不一致时清空配置信息； * 修改系统电压功能为预定义模式； * 增加PCB200的发行版本；
2017-11-27 * V2.26 - 20171128 * 修改一线通函数每次调用后都更新速度，解决一线通状态下速度调整时闪烁的问题； * 改正了相电压状态下速度调整时显示异常的问题；
    [bike.h, main.c, stm8s_it.c, yxt.c]
2017-11-28 * V2.27 - 20171128 * 增加RESET_CONFIGA功能，去掉程序检测到版本不一致时清空配置信息的功能；
2017-11-28 * V2.28 - 20171128 * 改正RESET_CONFIG时显示的功能，增加JIKE13050的Parking灯输出控制；
2017-12-01 * V2.29 - 20171128 * 去除MileResetTask中对速度和刹车状态的判断；改正上电打右转时进入MileResetTask后返回1，造成单次里程显示时间长的问题
    [bike.h, main.c, yxt.c]
2017-12-01 * V2.30 - 20171201 * 减小闪光器关闭时的判断时间，更改MileTask结构，优化显示效果；
2017-12-04 极客程序由VD48L72N改为VD48N72L
    [stm8s003f3.stp]
2017-12-13 * V2.31 - 20171214 * 增加对JINGPENG-12080的支持；
2017-12-15 20171215 增加对JINPENG_MR9737的支持……
    [JP-LED.SchDoc, JP-QDB.SchDoc, MR9737V2.0.SchDoc]
2017-12-17 * V2.32 - 20171214 * 完善对JINGPENG-12080的支持； *
2017-12-19 * V2.33 - 20171219 * 改电量外框常亮，调整TM1640通讯速度；
2018-01-04 * V2.35 - 20180104 * 修改48V系统电量显示最后一格电压值从481到479；
2018-01-11 * V2.37 - 20180110 * 速度调整时由于一线通速度不稳定造成显示跳动的问题，速度在进入调整模式时软件锁存； * 调整速度处理方式,一线通速度更新方式；
    [bike.h, main.c, yxt.c]
2018-01-12 * V2.37 - 20180112 * 速度调整时由于一线通速度不稳定造成显示跳动的问题，速度在进入调整模式时软件锁存； * 调整速度处理方式,一线通速度更新方式； * 修改里程调整显示时间的问题；
    [bike.c, bike.h]
2018-01-19 * V2.38 - 20180119 * 开机全显由芯片控制改为程序写入方式，JIKE13050全显时隐去左右转灯，正常工作时LCD上大灯不显示； *
2018-01-22 更改8794屏负号显示问题，
2018-01-23 * V2.39 - 20180123 * 改正温度显示范围问题； *
    [bike.c, bike.h, bl55072.c, main.c]
2018-03-10 * V2.40 - 20180310 * 关闭启动时的HotReset检测函数，避免开机时可能出现的无全屏显示的现象；
2018-03-12 增加VD48L72L
2018-03-18 JINPENG_QD版本关闭YXT,提高LED亮度为全亮，关闭PRND四个灯的显示；
